NortonDesignLab/imagotag-e300-dashboard/frame/preview.png

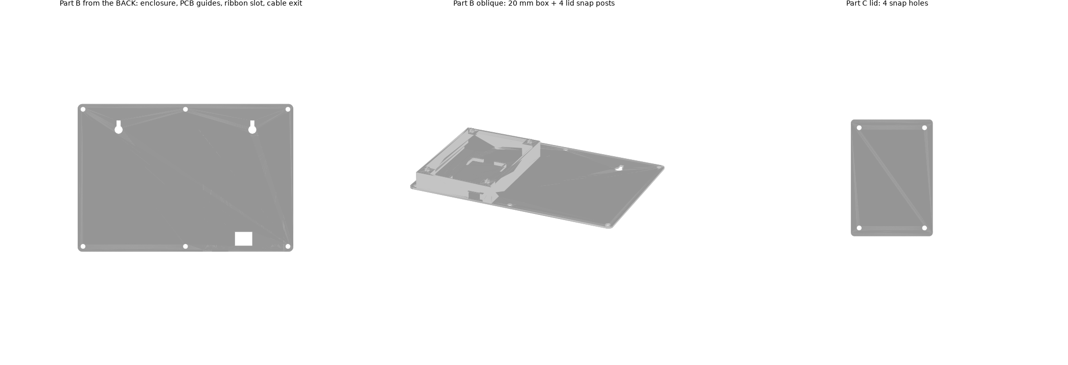
frame/preview.png
