NortonDesignLab/imagotag-e300-dashboard/NDLMessage/ndl_base_preview.png

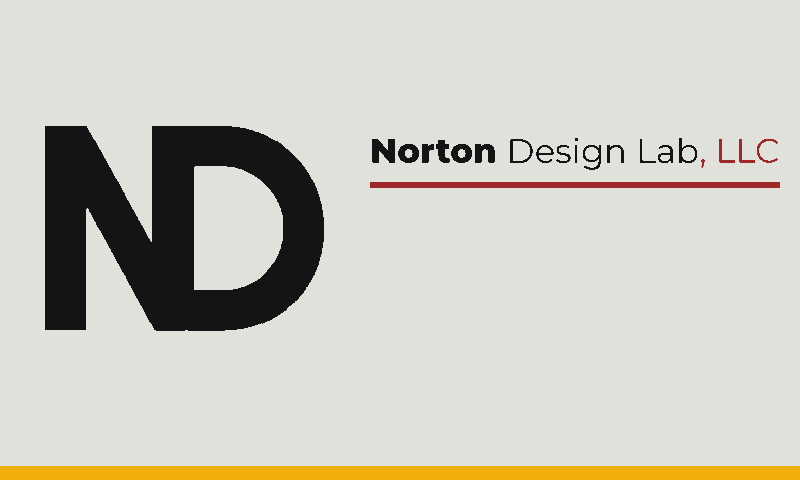
NDLMessage/ndl_base_preview.png
