NortonDesignLab/imagotag-e300-dashboard/NDLMessage/ndl_message_preview.png

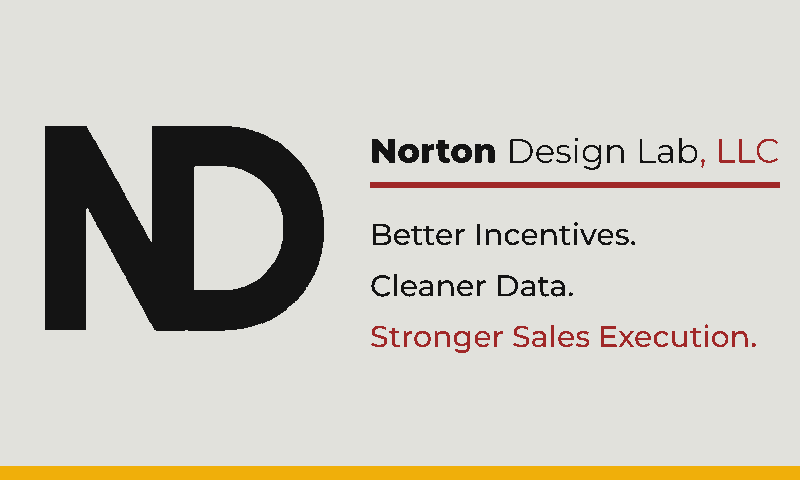
NDLMessage/ndl_message_preview.png
