NortonDesignLab/imagotag-e300-dashboard/frame/frame_both.3mf

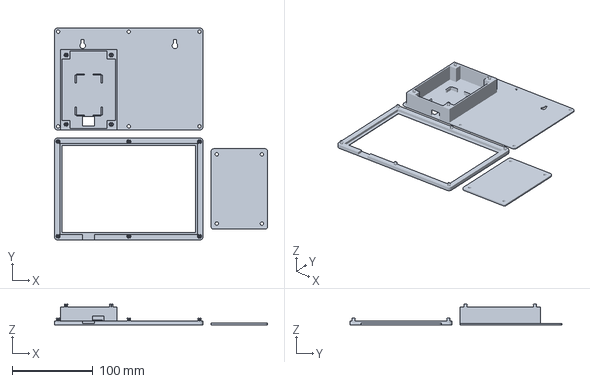
[picture p9: CAD file, 2026-10-08]
frame/frame_both.3mf
264.6 x 263.2 x 25.8 mm
