NortonDesignLab/imagotag-e300-dashboard/frame/openbox/open_box_70x100x20_wall2.stl

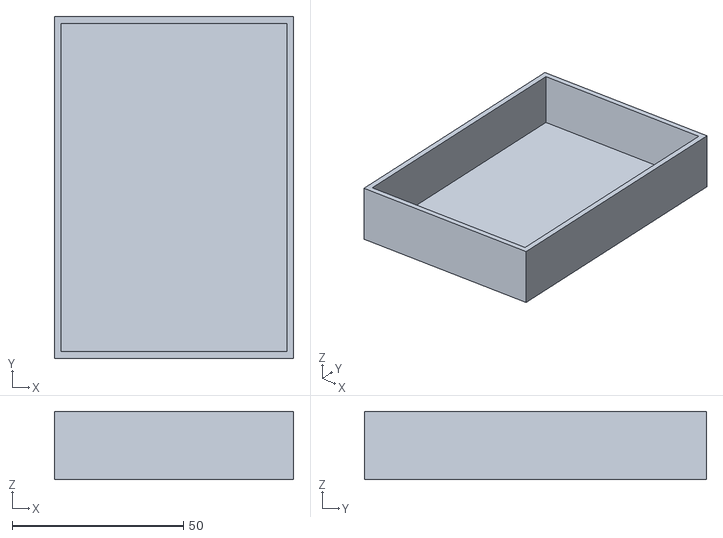
[picture p10: CAD file, 2026-10-07]
frame/openbox/open_box_70x100x20_wall2.stl
70.0 x 100.0 x 20.0
