NortonDesignLab/imagotag-e300-dashboard/frame/frame_lid.stl

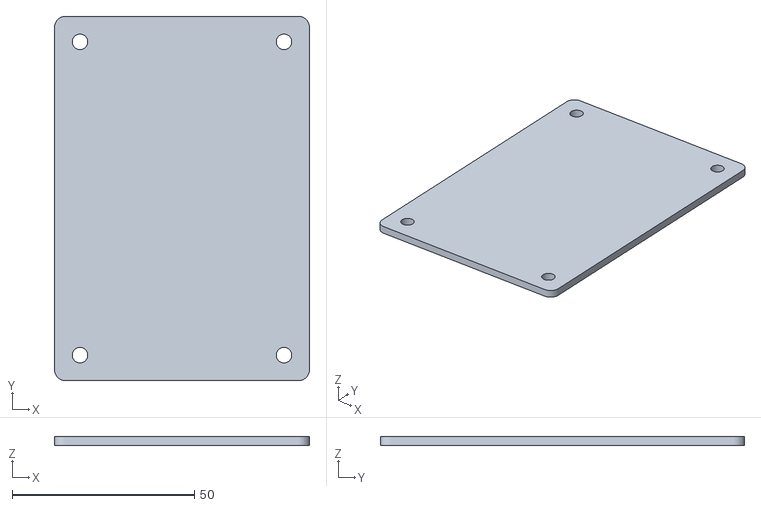
[picture p11: CAD file, 2026-10-06]
frame/frame_lid.stl
70.0 x 100.0 x 2.40
