NortonDesignLab/imagotag-e300-dashboard/frame/frame_front.stl

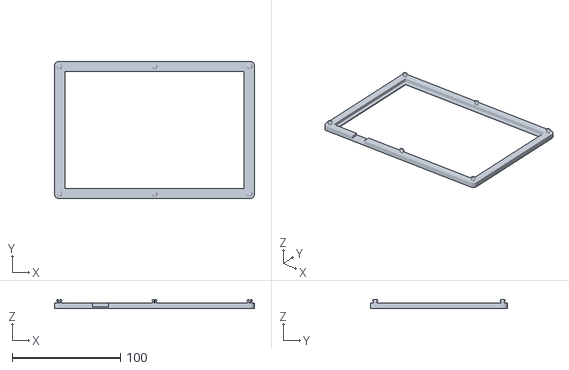
[picture p12: CAD file, 2026-10-06]
frame/frame_front.stl
184.6 x 126.6 x 8.50
