NortonDesignLab/imagotag-e300-dashboard/frame/frame_back.stl

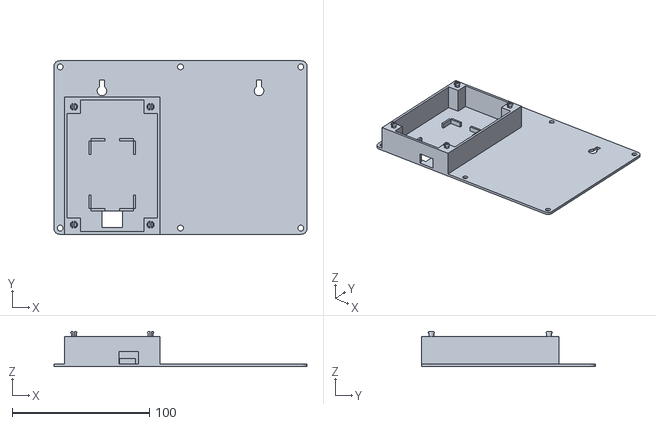
[picture p13: CAD file, 2026-10-06]
frame/frame_back.stl
184.6 x 126.6 x 25.8
