NortonDesignLab/imagotag-e300-dashboard/(list of files, cad)

Other CAD files:
frame/openbox/open_box_70x100x20_wall1.stl
frame/frame_both.stl
