NortonDesignLab/imagotag-e300-dashboard/WeatherPanel4C/WeatherPanel4C.ino

// Weather station display, 4-COLOR edition, driving the Imagotag/Vusion E300 7.4" panel =
// Pervasive Displays E2741QS0B3, Spectra 4 black/white/RED/YELLOW, 480x800 native, used in
// LANDSCAPE 800x480 (bb_epaper rotation 90). Runs on either of two driver boards (see the board
// select below): the Waveshare e-Paper ESP32 Driver Board Rev3 (ESP32-WROOM-32E) or the Seeed XIAO
// ePaper Display Board EE04 with a XIAO ESP32-S3 Plus.
//
// Port of WeatherEpaper (GxEPD2, 880x528 B/W/R) to bb_epaper. The fetch/parse half (AWN,
// ComEd, NWS, pollen.com, Open-Meteo, USGS, SWPC, Google News) is reused verbatim. The drawing half
// is re-laid out for 800x480 and gains yellow as a "caution" tier between black and red:
//   UV 3-5, pollen/asthma Medium, AQI 51-100, Kp 4, M5 quakes, lightning today but not in the last
//   hour, the ComEd hour still in progress; messages take ~yellow~.
// Yellow text is ringed in black (same trick as the NDL panel) because yellow on white is faint,
// and is never used below 12 pt.
//
// bb_epaper has no Adafruit GFX font support, and its 96 KB full-frame buffer starves TLS on this
// board, so a small Adafruit_GFX subclass pages the screen in column bands straight to the panel
// (see EpdGfx / pushScreen). bb_epaper is used for init, commands, refresh and sleep only.
// bb_epaper rejects any rect with a corner off-screen and does not clip x, so the bridge clips.
//
// Full refresh ~23 s, no fast mode. The paged renderer is kept on the S3 too (it has the RAM for a
// full frame, but paging costs nothing and keeps one code path).
// Needs bb_epaper from GIT master (EP74YR_480x800): compile with --library ../bb_epaper_git.

#include <WiFi.h>
#include <WiFiClientSecure.h>
#include <HTTPClient.h>
#include <ArduinoJson.h>
#include <bb_epaper.h>
#include <Adafruit_GFX.h>
#include <Fonts/FreeSansBold24pt7b.h>
#include <Fonts/FreeSansBold18pt7b.h>
#include <Fonts/FreeSansBold12pt7b.h>
#include <Fonts/FreeSans12pt7b.h>
#include <Fonts/FreeSans9pt7b.h>
#include <Fonts/FreeSansBold9pt7b.h>
#include "secrets.h"
#include <WebServer.h>
#include <ESPmDNS.h>

// Board select. The same sketch runs on two driver boards; the pins and the mDNS hostname are the
// only differences (the hostname differs so both boards can be on the LAN at once).
#if defined(ARDUINO_XIAO_ESP32S3_PLUS) || defined(ARDUINO_XIAO_ESP32S3)
// Seeed XIAO ePaper Display Board EE04 + XIAO ESP32-S3 Plus (16 MB flash, 8 MB PSRAM).
// FQBN esp32:esp32:XIAO_ESP32S3_Plus:PSRAM=opi,PartitionScheme=app3M_fat9M_16MB
#define BOARD_NAME "XIAO EE04 / ESP32-S3 Plus"
#define DC_PIN    10
#define RESET_PIN 38
#define BUSY_PIN  4
#define CS_PIN    44
#define SCK_PIN   7
#define MOSI_PIN  9
#define HOSTNAME  "ndl-panel-s3"
#else
// Waveshare e-Paper ESP32 Driver Board Rev3 (ESP32-WROOM-32E, 4 MB flash, no PSRAM).
// FQBN esp32:esp32:esp32:FlashSize=4M,PartitionScheme=huge_app
#define BOARD_NAME "Waveshare Rev3 / WROOM-32"
#define DC_PIN    27
#define RESET_PIN 26
#define BUSY_PIN  25
#define CS_PIN    15
#define SCK_PIN   13
#define MOSI_PIN  14
#define HOSTNAME  "ndl-panel"
#endif
#define ROTATION  90          // 270 flips the picture 180 degrees
#define SCR_W 800
#define SCR_H 480

// Colors are bb_epaper's own values, passed straight through Adafruit_GFX's 16-bit color.
#define C_BLACK  BBEP_BLACK
#define C_WHITE  BBEP_WHITE
#define C_YELLOW BBEP_YELLOW
#define C_RED    BBEP_RED

BBEPAPER bbep(EP74YR_480x800);

// Adafruit_GFX -> panel bridge, PAGED. The full 800x480 2-bpp frame is 96 KB, which this
// WROOM-32 cannot hold next to Wi-Fi + TLS (with it resident the largest free block fell to 32 KB
// and every HTTPS fetch failed). So, like GxEPD2 paging, each screen is drawn BAND_W logical
// columns at a time into a small buffer that is already in the panel's native layout, and
// streamed straight to the controller - the same bytes bbepWriteImage2bpp() sends for a 4-color
// panel at rotation 90: command 0x10, then one 120-byte native row per logical column x, packed
// 4 px/byte MSB-first from y = 479 down to 0. bb_epaper's own frame buffer is never allocated.
const int BAND_W = 80, ROW_B = SCR_H / 4;              // 10 bands of 80 columns, 9600 B buffer
static uint8_t* band = nullptr;                        // malloc'd at boot (static would crowd dram0)
static int bandX0 = 0;
class EpdGfx : public Adafruit_GFX {
 public:
  EpdGfx() : Adafruit_GFX(SCR_W, SCR_H) {}
  void drawPixel(int16_t x, int16_t y, uint16_t c) override {
    if (y < 0 || y >= SCR_H || x < bandX0 || x >= bandX0 + BAND_W) return;
    int nx = SCR_H - 1 - y;                            // native x runs bottom-up
    uint8_t* p = band + (x - bandX0) * ROW_B + (nx >> 2);
    int sh = (3 - (nx & 3)) * 2;
    *p = (*p & ~(3 << sh)) | ((c & 3) << sh);
  }
  void fillRect(int16_t x, int16_t y, int16_t w, int16_t h, uint16_t c) override {
    int x1 = max((int)x, bandX0), x2 = min((int)x + w - 1, bandX0 + BAND_W - 1);
    int y1 = max((int)y, 0),      y2 = min((int)y + h - 1, SCR_H - 1);
    for (int yy = y1; yy <= y2; yy++) for (int xx = x1; xx <= x2; xx++) drawPixel(xx, yy, c);
  }
  void drawFastHLine(int16_t x, int16_t y, int16_t w, uint16_t c) override { fillRect(x, y, w, 1, c); }
  void drawFastVLine(int16_t x, int16_t y, int16_t h, uint16_t c) override { fillRect(x, y, 1, h, c); }
  void fillScreen(uint16_t c) override { uint8_t v = c & 3; memset(band, v | v << 2 | v << 4 | v << 6, BAND_W * ROW_B); }
};
EpdGfx display;
static bool panelAsleep = false;

// ---------------- message-over-Wi-Fi ----------------
// POST /message  text=...&style=banner|full&ttl=<minutes, 0 = until cleared>
// POST /clear    ;  GET / = browser form.  Host: http://ndl-panel.local  (mDNS) or the board IP.
WebServer server(80);
String   msgText;                  // empty = no message
bool     msgFull    = false;       // full screen vs banner strip
uint32_t msgSetMs   = 0, msgTtlMs = 0;
bool     needRender = false;

// ---------------- ComEd hourly pricing ----------------
// northern Illinois. Free, no key. Two calls:
//   ?type=currenthouraverage -> JSON [{millisUTC,price}]  (45 B)
//   ?type=day&date=YYYYMMDD  -> JavaScript, NOT JSON: [[Date.UTC(y,m,d,H,0,0), price], ...]  (~550 B)
// The Date.UTC() hours are LOCAL clock hours despite the name, and they are HOUR-ENDING: H = the
// hour that ended at H:00 (verified 26 Oct 2026: entry 18 = 17.5c = the mean of the 5-minute
// prices from 5-6 PM CDT). So H goes into slot H-1 of a local 0..23 hour-starting array; H = 0 is
// yesterday's 11 PM hour and is dropped. The hour in progress is never in the feed.
const float ALERT_C = 8.0f;              // cents/kWh: at or above this is drawn red
float  comedHour[24];
float  comedCur = NAN;
int    comedN = 0;
time_t comedAt = 0;
const uint32_t COMED_MS = 5UL * 60 * 1000;
uint32_t lastComed = 0;

// ---------------- NWS forecast ----------------
// Free, no key, no special User-Agent needed. The gridpoint is fixed for a location - it came
// NWS_GRID (secrets.h) comes from GET /points/<lat>,<lon> -> gridId/gridX/gridY. Re-derive it
// if SITE_LATITUDE/SITE_LONGITUDE change. Body is ~13.6 KB, well inside BODY_CAP.
const char* NWS_URL = "https://api.weather.gov/gridpoints/" NWS_GRID "/forecast";
struct Period { char name[20]; char shortF[48]; char wind[24]; int temp; int pop; bool day; };
Period  fc[5];
int     fcN = 0;
char    fcDetail[320] = "";
time_t  fcAt = 0;
const uint32_t FC_MS = 30UL * 60 * 1000;    // NWS refreshes about hourly
uint32_t lastFc = 0;

// ---------------- pollen + air quality ----------------
// Pollen: pollen.com by ZIP, free/keyless but REQUIRES a Referer header or it returns nothing.
//   Index is 0-12 and it names the active triggers. Its /mold/ endpoint returns null for some ZIPs -
//   there is effectively no mold data for this area (NAB counts have no public API).
// AQI: Open-Meteo air-quality, free/keyless. NOTE its pollen fields are Europe-only and come back
//   null for US coordinates, which is why pollen comes from pollen.com instead.
const char* POLLEN_ZIP = SITE_ZIP;
float  pollenIdx = NAN;
char   pollenTrig[72] = "";
int    aqiVal = -1;
float  pm25 = NAN;
float  asthmaIdx = NAN;
float  pm10 = NAN, ozone = NAN;
float  pollen5[5];
int    p5mon[5], p5day[5], pollen5N = 0;
time_t airAt = 0;
const uint32_t AIR_MS = 30UL * 60 * 1000;
uint32_t lastAir = 0;

// ---------------- NWS severe weather alerts ----------------
// api.weather.gov/alerts/active?point=lat,lon - free, keyless, tiny payload (196 B when clear).
// Only Tornado / Severe Thunderstorm WARNINGS raise the box (watches and advisories do not).
bool   alertActive = false;
char   alertEvent[48] = "";
char   alertArea[72]  = "";
time_t alertEnds = 0;
int    alertRank = 0;                        // 2 = tornado, 1 = thunderstorm
const uint32_t ALERT_MS = 2UL * 60 * 1000;   // time-critical: poll every 2 min
uint32_t lastAlert = 0;
bool     alertTest = false;      // /testalert holds the box up without a real storm

// ---------------- WSJ headlines ----------------
// WSJ's own RSS (feeds.a.dj.com) is DEAD - frozen since 27 Jan 2025 (origin last-modified proves
// it, and a cache-buster changes nothing). Google News filtered to site:wsj.com is live. The feed
// is ~120 KB but the top 8 items land inside 11 KB, so we read ~16 KB and hang up.
const char* NEWS_URL =
  "https://news.google.com/rss/search?q=site:wsj.com+when:2d&hl=en-US&gl=US&ceid=US:en";
struct Story { char title[124]; time_t t; };
const int NEWS_MAX = 8;
Story  NEWS[NEWS_MAX];
int    newsN = 0;
time_t newsAt = 0;
const uint32_t NEWS_MS = 30UL * 60 * 1000;
uint32_t lastNews = 0;

// ---------------- river gauge (USGS) ----------------
// RIVER_USGS_SITE from secrets.h (any USGS gauge with gage height). Keyless, 15-minute cadence.
// 00065 = gage height (ft), 00060 = streamflow (ft3/s).
// Flood stages (ft) from the NWS gauge page water.noaa.gov/gauges/<RIVER_NWSLI>, via secrets.h.
const char* USGS_SITE = RIVER_USGS_SITE;
const float FLOOD_ACTION   = RIVER_FLOOD_ACTION;
const float FLOOD_MINOR    = RIVER_FLOOD_MINOR;     // "flood stage"
const float FLOOD_MODERATE = RIVER_FLOOD_MODERATE;
const float FLOOD_MAJOR    = RIVER_FLOOD_MAJOR;
float  rivStage = NAN, rivFlow = NAN, rivFirst = NAN;
float  rivHist[48]; int rivHistN = 0;
time_t rivAt = 0;
const uint32_t RIVER_MS = 15UL * 60 * 1000;
// USGS/NOAA 503 transiently. A failure at boot used to leave a screen blank until the next full
// interval - 15 min for the river. Re-attempt in 2 min instead. Due-times are compared as signed
// differences so millis() rollover is handled.
const uint32_t RETRY_MS = 2UL * 60 * 1000;
uint32_t riverDue = 0, quakeDue = 0, spaceDue = 0;
uint32_t lastRiver = 0;

// ---------------- earthquakes (USGS) ----------------
struct Quake { char place[58]; float mag; float dist; time_t t; };   // dist = miles from SITE
const int QK_MAX = 7;
Quake  QK[QK_MAX]; int qkN = 0, qkTotal = 0; float qkBig = 0; time_t qkAt = 0;
const uint32_t QUAKE_MS = 15UL * 60 * 1000;
uint32_t lastQuake = 0;

// ---------------- space weather (NOAA SWPC) ----------------
float  kpNow = NAN; float kpHist[24]; time_t kpTime[24]; int kpHistN = 0; time_t kpAt = 0;
const uint32_t SPACE_MS = 30UL * 60 * 1000;
uint32_t lastSpace = 0;

// ---------------- screen rotation ----------------
enum Screen { SCR_WEATHER = 0, SCR_FORECAST = 1, SCR_AIR = 2, SCR_RIVER = 3, SCR_SPACE = 4,
              SCR_QUAKE = 5, SCR_COMED = 6, SCR_NEWS = 7 };
const int NUM_SCREENS = 8;
// Rotation is these five in order (Bradley, 27 Oct 2026). Space, quake and news are still
// compiled and reachable with /screen?s=..., just not in the cycle.
const Screen CYCLE[] = { SCR_WEATHER, SCR_FORECAST, SCR_COMED, SCR_AIR, SCR_RIVER };
const int NCYCLE = sizeof(CYCLE) / sizeof(CYCLE[0]);
int rotSlot = 0;
Screen   curScreen = SCR_WEATHER;
uint32_t rotateMs  = 3UL * 60 * 1000;           // 0 = stay on the current screen
uint32_t lastRotate = 0;

const float INHG2MB = 33.8639f;
const uint32_t CURRENT_MS = 10UL * 60 * 1000;   // poll current every 10 min (Bradley, 21 Sep 2026)
const uint32_t HISTORY_MS = 10UL * 60 * 1000;   // poll history every 10 min
static const int HIST_MAX   = 60;
static const int HIST_LIMIT = 48;               // 5-min samples -> 4 h (covers the 3 h trend)
const float TREND_MB = 0.7f;
const double SITE_LAT = SITE_LATITUDE, SITE_LON = SITE_LONGITUDE;   // from secrets.h

// ---------------- data ----------------
struct Obs {
  float tempf = NAN, humidity = NAN, feelsLike = NAN, dewPoint = NAN;
  float baromRel = NAN, baromAbs = NAN, windMph = NAN, windGust = NAN, dailyRain = NAN;
  float ltgDay = NAN, ltgHour = NAN, ltgDist = NAN; time_t ltgTime = 0;
  float windDir = NAN, windDirAvg = NAN, windAvg = NAN, maxGust = NAN;
  float uv = NAN, solar = NAN, tempIn = NAN, humIn = NAN;
  float rainHour = NAN, rainWeek = NAN, rainMonth = NAN, rainYear = NAN;
  time_t lastRainT = 0;
  time_t t = 0;
  bool ok = false;
};
Obs cur;
float  histP[HIST_MAX];
time_t histT[HIST_MAX];
int    histN = 0;
float  trendDelta = NAN;
int    trendSpanMin = 0;
String lastErr;
uint16_t fetchOk = 0, fetchTotal = 0;
time_t lastGood = 0;
// Today's high/low. Not in the AWN feed, so backfilled from midnight at boot by paging the
// history endpoint with endDate (48 recs / ~36 KB / 4 h per call), then tracked forward.
float  dayHi = NAN, dayLo = NAN;
time_t dayHiT = 0, dayLoT = 0;
int    dayKey = -1;                 // tm_yday the hi/lo belong to

// ---------------- helpers ----------------
static String fmtTime(time_t t, const char* fmt = "%l:%M %p") {
  if (t < 1000000000) return "--:--";     // 0 / pre-NTP values render as "6:00 PM" (epoch in Chicago)
  struct tm tm; localtime_r(&t, &tm);
  char buf[32]; strftime(buf, sizeof buf, fmt, &tm);
  String s(buf); s.trim(); return s;
}
static String f0(float v, const char* suffix = "") { char b[16]; if (isnan(v)) return "--"; snprintf(b, sizeof b, "%.0f%s", v, suffix); return String(b); }
static String f1(float v, const char* suffix = "") { char b[16]; if (isnan(v)) return "--"; snprintf(b, sizeof b, "%.1f%s", v, suffix); return String(b); }

// ---------------- Ambient Weather fetch (reused from ideaspark / C6) ----------------
static const char* KEEP[] = {"dateutc","tempf","humidity","feelsLike","dewPoint","baromrelin",
                             "baromabsin","windspeedmph","windgustmph","dailyrainin",
                             "lightning_day","lightning_hour","lightning_distance","lightning_time",
                             "winddir","winddir_avg10m","windspdmph_avg10m","maxdailygust",
                             "uv","solarradiation","tempinf","humidityin",
                             "hourlyrainin","weeklyrainin","monthlyrainin","yearlyrainin","lastRain"};
static const size_t BODY_CAP = 48000;
static char bodyBuf[BODY_CAP];
static bool httpGetRaw(const String& url, size_t& outLen, size_t maxBytes = BODY_CAP - 1,
                       const char* referer = nullptr) {
  uint32_t t0 = millis();
  WiFiClientSecure client; client.setInsecure();
  HTTPClient https;
  https.useHTTP10(true);
  https.setTimeout(15000);
  https.setUserAgent("Mozilla/5.0 (X11; Linux x86_64)");   // some feeds reject the default ESP32 UA
  if (!https.begin(client, url)) { lastErr = "begin failed"; return false; }
  if (referer) https.addHeader("Referer", referer);   // pollen.com returns nothing without it
  int code = https.GET();
  if (code != HTTP_CODE_OK) {
    lastErr = "HTTP " + String(code);
    if (code == 401) lastErr += " keys";
    if (code == 429) lastErr += " rate";
    Serial.printf("  GET %s FAILED: %s\n", url.substring(0, 45).c_str(), lastErr.c_str());
    https.end(); return false;
  }
  NetworkClient* st = https.getStreamPtr();
  size_t len = 0; uint32_t last = millis();
  if (maxBytes > BODY_CAP - 1) maxBytes = BODY_CAP - 1;
  while (millis() - last < 5000 && len < maxBytes) {
    int n = st->available();
    if (n > 0) {
      if ((size_t)n > maxBytes - len) n = maxBytes - len;
      n = st->read((uint8_t*)bodyBuf + len, n);
      if (n > 0) { len += n; last = millis(); }
    } else { if (!st->connected()) break; delay(1); }
  }
  https.end();
  bodyBuf[len] = 0; outLen = len;
  Serial.printf("  GET %s -> %u bytes in %lu ms (heap %u)\n", url.substring(0, 45).c_str(),
                (unsigned)len, (unsigned long)(millis() - t0), (unsigned)ESP.getFreeHeap());
  return len > 0;
}
static bool awGet(const String& url, JsonDocument& doc, const JsonDocument& filter,
                  const char* referer = nullptr) {
  size_t len;
  if (!httpGetRaw(url, len, BODY_CAP - 1, referer)) return false;
  DeserializationError err = deserializeJson(doc, bodyBuf, len, DeserializationOption::Filter(filter));
  if (err) { lastErr = String("JSON ") + err.c_str(); Serial.printf("  parse: %s\n", err.c_str()); return false; }
  return true;
}
// "2026-09-27T12:57:00.000Z" -> UTC epoch (days-from-civil, Howard Hinnant)
static time_t parseISO(const char* s) {
  int y, mo, d, h, mi, se;
  if (!s || sscanf(s, "%d-%d-%dT%d:%d:%d", &y, &mo, &d, &h, &mi, &se) != 6) return 0;
  y -= mo <= 2;
  long era = (y >= 0 ? y : y - 399) / 400;
  unsigned yoe = (unsigned)(y - era * 400);
  unsigned doy = (153 * (mo + (mo > 2 ? -3 : 9)) + 2) / 5 + d - 1;
  unsigned doe = yoe * 365 + yoe / 4 - yoe / 100 + doy;
  long days = era * 146097L + (long)doe - 719468L;
  time_t t = (time_t)(days * 86400L + h * 3600L + mi * 60L + se);
  const char* z = s + 19;                       // past "....-..-..T..:..:.."
  while (*z == '.' || (*z >= '0' && *z <= '9')) z++;   // skip fractional seconds
  if (*z == '+' || *z == '-') {                 // NWS stamps carry -06:00 etc, not Z
    int oh = 0, om = 0;
    if (sscanf(z + 1, "%d:%d", &oh, &om) == 2) {
      long off = oh * 3600L + om * 60L;
      t += (*z == '+') ? -off : off;
    }
  }
  return t;
}
static const char* CARD16[] = {"N","NNE","NE","ENE","E","ESE","SE","SSE","S","SSW","SW","WSW","W","WNW","NW","NNW"};
static String cardinal(float deg) {
  if (isnan(deg)) return "";
  int i = ((int)((deg + 11.25f) / 22.5f)) % 16; if (i < 0) i += 16;
  return String(CARD16[i]);
}
// ESP32 newlib's struct tm has no tm_gmtoff, so derive the UTC offset by comparing
// the local and UTC breakdowns of the same instant (handles the day/month wrap).
static long tzOffsetSec(time_t t) {
  struct tm lt, gt;
  localtime_r(&t, &lt); gmtime_r(&t, &gt);
  long d = (lt.tm_hour * 3600L + lt.tm_min * 60L + lt.tm_sec)
         - (gt.tm_hour * 3600L + gt.tm_min * 60L + gt.tm_sec);
  int dd = lt.tm_mday - gt.tm_mday;
  if (dd == 1 || dd < -1) d += 86400;        // local is the next day
  else if (dd == -1 || dd > 1) d -= 86400;   // local is the previous day
  return d;
}
// Sunrise equation (NOAA / Wikipedia), good to ~1-2 min. Returns local minutes from midnight.
static void sunTimes(int y, int mo, int d, double lat, double lon, long tzoff, double& rise, double& set) {
  long a = (14 - mo) / 12, yy = y + 4800 - a, mm = mo + 12 * a - 3;
  long jdn = d + (153 * mm + 2) / 5 + 365 * yy + yy / 4 - yy / 100 + yy / 400 - 32045;
  double n = (double)jdn - 2451545.0 + 0.0008;
  double Js = n - lon / 360.0;
  double M = fmod(357.5291 + 0.98560028 * Js, 360.0), Mr = M * DEG_TO_RAD;
  double C = 1.9148 * sin(Mr) + 0.0200 * sin(2 * Mr) + 0.0003 * sin(3 * Mr);
  double lam = fmod(M + C + 180.0 + 102.9372, 360.0), lr = lam * DEG_TO_RAD;
  double Jtr = 2451545.0 + Js + 0.0053 * sin(Mr) - 0.0069 * sin(2 * lr);
  double sinDec = sin(lr) * sin(23.4397 * DEG_TO_RAD);
  double cosDec = cos(asin(sinDec)), latr = lat * DEG_TO_RAD;
  double cosW = (sin(-0.833 * DEG_TO_RAD) - sin(latr) * sinDec) / (cos(latr) * cosDec);
  if (cosW > 1 || cosW < -1) { rise = set = NAN; return; }   // polar day / night
  double w = acos(cosW) * RAD_TO_DEG;
  auto toLocal = [&](double J) {
    double mins = (J - (double)jdn + 0.5) * 1440.0 + tzoff / 60.0;
    while (mins < 0) mins += 1440; while (mins >= 1440) mins -= 1440;
    return mins;
  };
  rise = toLocal(Jtr - w / 360.0); set = toLocal(Jtr + w / 360.0);
}
static String fmtMin(double m) {
  if (isnan(m)) return "--";
  int t = (int)(m + 0.5), h = (t / 60) % 24, mi = t % 60, hh = h % 12; if (!hh) hh = 12;
  char b[16]; snprintf(b, sizeof b, "%d:%02d %s", hh, mi, h < 12 ? "AM" : "PM"); return String(b);
}
static String agoStr(time_t then, time_t now) {
  if (then <= 0) return "never";
  long s = now - then; if (s < 0) s = 0;
  if (s < 3600) return String(s / 60) + "m ago";
  if (s < 86400) return String(s / 3600) + "h ago";
  return String(s / 86400) + "d ago";
}
static void parseObs(JsonObject o) {
  cur.tempf     = o["tempf"]        | NAN;
  cur.humidity  = o["humidity"]     | NAN;
  cur.feelsLike = o["feelsLike"]    | NAN;
  cur.dewPoint  = o["dewPoint"]     | NAN;
  cur.baromRel  = (o["baromrelin"] | NAN) * INHG2MB;
  cur.baromAbs  = (o["baromabsin"] | NAN) * INHG2MB;
  cur.windMph   = o["windspeedmph"] | NAN;
  cur.windGust  = o["windgustmph"]  | NAN;
  cur.dailyRain = o["dailyrainin"]  | NAN;
  cur.ltgDay    = o["lightning_day"]      | NAN;
  cur.ltgHour   = o["lightning_hour"]     | NAN;
  cur.ltgDist   = o["lightning_distance"] | NAN;
  cur.ltgTime   = (time_t)((o["lightning_time"] | 0.0) / 1000.0);
  cur.windDir   = o["winddir"]            | NAN;
  cur.windDirAvg= o["winddir_avg10m"]     | NAN;
  cur.windAvg   = o["windspdmph_avg10m"]  | NAN;
  cur.maxGust   = o["maxdailygust"]       | NAN;
  cur.uv        = o["uv"]                 | NAN;
  cur.solar     = o["solarradiation"]     | NAN;
  cur.tempIn    = o["tempinf"]            | NAN;
  cur.humIn     = o["humidityin"]         | NAN;
  cur.rainHour  = o["hourlyrainin"]       | NAN;
  cur.rainWeek  = o["weeklyrainin"]       | NAN;
  cur.rainMonth = o["monthlyrainin"]      | NAN;
  cur.rainYear  = o["yearlyrainin"]       | NAN;
  cur.lastRainT = parseISO(o["lastRain"]  | "");
  cur.t         = (time_t)((o["dateutc"] | 0.0) / 1000.0);
  cur.ok        = true;
}
static void computeTrend() {
  if (histN < 2 || !cur.ok || isnan(cur.baromRel)) { trendDelta = NAN; return; }
  time_t target = cur.t - 3 * 3600; int best = -1;
  for (int i = 0; i < histN; i++)
    if (best < 0 || labs((long)(histT[i] - target)) < labs((long)(histT[best] - target))) best = i;
  if (best < 0) return;
  trendDelta = cur.baromRel - histP[best];
  trendSpanMin = (int)((cur.t - histT[best]) / 60);
}
bool fetchCurrent() {
  String url = String("https://rt.ambientweather.net/v1/devices?apiKey=") + AW_API_KEY +
               "&applicationKey=" + AW_APP_KEY;
  JsonDocument filter;
  filter[0]["macAddress"] = true;
  for (auto k : KEEP) filter[0]["lastData"][k] = true;
  JsonDocument doc;
  if (!awGet(url, doc, filter)) return false;
  JsonArray arr = doc.as<JsonArray>();
  if (arr.size() == 0) { lastErr = "no devices"; return false; }
  JsonObject dev = arr[0];
  for (JsonObject d : arr) if (String(d["macAddress"] | "").equalsIgnoreCase(AW_MAC)) { dev = d; break; }
  JsonObject o = dev["lastData"];
  if (o.isNull()) { lastErr = "no lastData"; return false; }
  parseObs(o);
  if (histN > 0 && cur.t > histT[histN - 1] && !isnan(cur.baromRel)) {
    if (histN == HIST_MAX) { memmove(histP, histP + 1, sizeof(float) * (HIST_MAX - 1)); memmove(histT, histT + 1, sizeof(time_t) * (HIST_MAX - 1)); histN--; }
    histP[histN] = cur.baromRel; histT[histN] = cur.t; histN++;
  }
  if (!isnan(cur.tempf) && cur.t > 0) {            // extend today's hi/lo with the new reading
    struct tm lt; localtime_r(&cur.t, &lt);
    if (lt.tm_yday == dayKey) {
      if (isnan(dayHi) || cur.tempf > dayHi) { dayHi = cur.tempf; dayHiT = cur.t; }
      if (isnan(dayLo) || cur.tempf < dayLo) { dayLo = cur.tempf; dayLoT = cur.t; }
    }
  }
  computeTrend(); time(&lastGood); lastErr = ""; return true;
}
bool fetchHistory() {
  String url = String("https://rt.ambientweather.net/v1/devices/") + AW_MAC +
               "?apiKey=" + AW_API_KEY + "&applicationKey=" + AW_APP_KEY +
               "&limit=" + String(HIST_LIMIT);
  JsonDocument filter;                       // history only needs these two - keeps the parsed doc small
  filter[0]["dateutc"] = true; filter[0]["baromrelin"] = true;
  JsonDocument doc;
  if (!awGet(url, doc, filter)) return false;
  JsonArray arr = doc.as<JsonArray>();
  int n = arr.size();
  if (n == 0) { lastErr = "no data"; return false; }
  if (n > HIST_MAX) n = HIST_MAX;
  histN = 0;
  for (int i = n - 1; i >= 0; i--) {
    JsonObject o = arr[i];
    histP[histN] = (o["baromrelin"] | NAN) * INHG2MB;
    histT[histN] = (time_t)((o["dateutc"] | 0.0) / 1000.0);
    histN++;
  }
  if (!cur.ok) { parseObs(arr[0]); time(&lastGood); }
  computeTrend(); lastErr = ""; return true;
}
// ---------------- river / quakes / space weather fetches ----------------
bool fetchRiver() {
  char url[256];
  snprintf(url, sizeof url,
           "https://waterservices.usgs.gov/nwis/iv/?format=json&sites=%s"
           "&parameterCd=00065,00060&period=P1D", USGS_SITE);
  JsonDocument filter;
  JsonObject ts = filter["value"]["timeSeries"][0].to<JsonObject>();
  ts["variable"]["variableCode"][0]["value"] = true;
  ts["values"][0]["value"][0]["value"] = true;
  JsonDocument doc;
  if (!awGet(url, doc, filter)) return false;
  rivHistN = 0;
  for (JsonObject t : doc["value"]["timeSeries"].as<JsonArray>()) {
    String code = t["variable"]["variableCode"][0]["value"] | "";
    JsonArray v = t["values"][0]["value"];
    if (v.size() == 0) continue;
    float last = atof(v[v.size() - 1]["value"] | "nan");
    if (code == "00060") { rivFlow = last; continue; }
    if (code != "00065") continue;
    rivStage = last;
    rivFirst = atof(v[0]["value"] | "nan");
    int n = v.size(), stride = n > 48 ? (n + 47) / 48 : 1;   // downsample to <=48 points
    for (int i = 0; i < n && rivHistN < 48; i += stride) {
      float f = atof(v[i]["value"] | "nan");
      if (!isnan(f)) rivHist[rivHistN++] = f;
    }
  }
  if (isnan(rivStage)) { lastErr = "no stage"; return false; }
  time(&rivAt);
  Serial.printf("river: %.2f ft, %.0f ft3/s, %d pts\n", rivStage, rivFlow, rivHistN);
  return true;
}
static float haversineMi(double lat1, double lon1, double lat2, double lon2) {
  const double R = 3958.8;                                   // mean earth radius, miles
  double dLat = (lat2 - lat1) * DEG_TO_RAD, dLon = (lon2 - lon1) * DEG_TO_RAD;
  double a = sin(dLat / 2) * sin(dLat / 2) +
             cos(lat1 * DEG_TO_RAD) * cos(lat2 * DEG_TO_RAD) * sin(dLon / 2) * sin(dLon / 2);
  return (float)(2.0 * R * asin(sqrt(a)));
}
bool fetchQuakes() {
  JsonDocument filter;
  JsonObject ff = filter["features"][0].to<JsonObject>();
  ff["properties"]["mag"] = true; ff["properties"]["place"] = true; ff["properties"]["time"] = true;
  ff["geometry"]["coordinates"] = true;
  // US only (Bradley: "US is more interesting"). The canned summary feeds are global, so use the
  // FDSN query API with a US bounding box - covers the lower 48 plus Alaska and Hawaii. Sorted
  // nearest-first below, so lower-48 events lead and Alaska falls to the bottom.
  // M2.5+/24 h gives ~15 events (~11 KB); the lower 48 alone gives only ~6, too sparse.
  time_t nw; time(&nw);
  struct tm g; gmtime_r(&nw, &g);                       // FDSN wants UTC
  time_t st = nw - 86400; struct tm gs; gmtime_r(&st, &gs);
  char ts[24]; strftime(ts, sizeof ts, "%Y-%m-%dT%H:%M:%S", &gs);
  char url[288];
  snprintf(url, sizeof url,
           "https://earthquake.usgs.gov/fdsnws/event/1/query?format=geojson&orderby=time"
           "&minlatitude=17&maxlatitude=72&minlongitude=-180&maxlongitude=-64"
           "&minmagnitude=2.5&starttime=%s", ts);
  JsonDocument doc;
  if (!awGet(url, doc, filter)) return false;
  JsonArray fs = doc["features"];
  qkTotal = fs.size(); qkN = 0; qkBig = 0;
  for (JsonObject f : fs) {
    float m = f["properties"]["mag"] | NAN;
    if (isnan(m)) continue;
    if (m > qkBig) qkBig = m;                                // largest across the WHOLE feed
    JsonArray c = f["geometry"]["coordinates"];
    if (c.size() < 2) continue;
    float d = haversineMi(SITE_LAT, SITE_LON, c[1] | 0.0, c[0] | 0.0);
    // keep the QK_MAX nearest, insertion-sorted by distance
    if (qkN == QK_MAX && d >= QK[qkN - 1].dist) continue;
    int pos = qkN < QK_MAX ? qkN : QK_MAX - 1;
    while (pos > 0 && QK[pos - 1].dist > d) { QK[pos] = QK[pos - 1]; pos--; }
    char raw[96]; strlcpy(raw, f["properties"]["place"] | "", sizeof raw);
    asciiClean(QK[pos].place, sizeof QK[pos].place, raw);
    QK[pos].mag = m; QK[pos].dist = d;
    QK[pos].t = (time_t)((double)(f["properties"]["time"] | 0.0) / 1000.0);
    if (qkN < QK_MAX) qkN++;
  }
  time(&qkAt);
  Serial.printf("quakes(US): %d of %d (M2.5+ 24h), nearest %.0f mi, largest M%.1f\n",
                qkN, qkTotal, qkN ? QK[0].dist : -1.0f, qkBig);
  return qkN > 0;
}
bool fetchSpace() {
  JsonDocument filter;
  filter[0]["Kp"] = true; filter[0]["time_tag"] = true;
  JsonDocument doc;
  if (!awGet("https://services.swpc.noaa.gov/products/noaa-planetary-k-index.json", doc, filter))
    return false;
  JsonArray a = doc.as<JsonArray>();
  if (!a.size()) { lastErr = "no kp"; return false; }
  int n = a.size(), start = n > 24 ? n - 24 : 0;     // last 24 samples = 3 days at 3 h
  kpHistN = 0;
  for (int i = start; i < n; i++) {
    float k = a[i]["Kp"] | NAN;
    if (!isnan(k) && kpHistN < 24) {
      kpTime[kpHistN] = parseISO(a[i]["time_tag"] | "");   // SWPC time_tag is bare UTC
      kpHist[kpHistN++] = k;
    }
  }
  kpNow = kpHistN ? kpHist[kpHistN - 1] : NAN;
  time(&kpAt);
  Serial.printf("space: Kp %.2f (%d samples)\n", kpNow, kpHistN);
  return true;
}

// ---------------- pollen + AQI fetch ----------------
static const char* pollenBand(float v) {
  if (isnan(v)) return "";
  if (v < 2.5f) return "Low";  if (v < 4.9f) return "Low-Med";
  if (v < 7.3f) return "Medium"; if (v < 9.7f) return "Med-High";
  return "High";
}
static const char* aqiBand(int a) {
  if (a <= 50)  return "Good";       if (a <= 100) return "Moderate";
  if (a <= 150) return "Unhealthy-Sens"; if (a <= 200) return "Unhealthy";
  if (a <= 300) return "Very Unhealthy";
  return "Hazardous";
}
bool fetchAir() {
  bool any = false;
  { String url = String("https://www.pollen.com/api/forecast/current/pollen/") + POLLEN_ZIP;
    String ref = String("https://www.pollen.com/forecast/current/pollen/") + POLLEN_ZIP;
    JsonDocument filter;
    JsonObject pf = filter["Location"]["periods"][0].to<JsonObject>();
    pf["Index"] = true; pf["Type"] = true;
    pf["Triggers"][0]["Name"] = true;
    JsonDocument doc;
    if (awGet(url, doc, filter, ref.c_str())) {
      for (JsonObject per : doc["Location"]["periods"].as<JsonArray>()) {
        if (String(per["Type"] | "") != "Today") continue;
        pollenIdx = per["Index"] | NAN;
        pollenTrig[0] = 0;
        int k = 0;
        for (JsonObject tg : per["Triggers"].as<JsonArray>()) {
          const char* nm = tg["Name"] | "";
          if (!nm[0] || k >= 3) continue;                 // three is all that fits on the line
          if (k) strlcat(pollenTrig, ", ", sizeof pollenTrig);
          strlcat(pollenTrig, nm, sizeof pollenTrig);
          k++;
        }
        any = true;
      }
    }
  }
  delay(300);
  { String url = String("https://www.pollen.com/api/forecast/current/asthma/") + POLLEN_ZIP;
    String ref = String("https://www.pollen.com/forecast/current/asthma/") + POLLEN_ZIP;
    JsonDocument filter;
    JsonObject pf = filter["Location"]["periods"][0].to<JsonObject>();
    pf["Index"] = true; pf["Type"] = true;
    JsonDocument doc;
    if (awGet(url, doc, filter, ref.c_str()))
      for (JsonObject per : doc["Location"]["periods"].as<JsonArray>())
        if (String(per["Type"] | "") == "Today") { asthmaIdx = per["Index"] | NAN; any = true; }
  }
  delay(300);
  { String url = String("https://www.pollen.com/api/forecast/extended/pollen/") + POLLEN_ZIP;
    String ref = String("https://www.pollen.com/forecast/extended/pollen/") + POLLEN_ZIP;
    JsonDocument filter;
    JsonObject pf = filter["Location"]["periods"][0].to<JsonObject>();
    pf["Index"] = true; pf["Period"] = true;
    JsonDocument doc;
    if (awGet(url, doc, filter, ref.c_str())) {
      pollen5N = 0;
      for (JsonObject per : doc["Location"]["periods"].as<JsonArray>()) {
        if (pollen5N >= 5) break;
        int yy, mm, dd;
        const char* pd = per["Period"] | "";          // "2026-09-29T15:37:50.027"
        if (sscanf(pd, "%d-%d-%d", &yy, &mm, &dd) != 3) continue;
        pollen5[pollen5N] = per["Index"] | NAN;
        p5mon[pollen5N] = mm; p5day[pollen5N] = dd;
        pollen5N++;
      }
      any = true;
    }
  }
  { char url[224];
    snprintf(url, sizeof url,
             "https://air-quality-api.open-meteo.com/v1/air-quality?latitude=%.4f&longitude=%.4f"
             "&current=us_aqi,pm2_5,pm10,ozone&timezone=America%%2FChicago", SITE_LAT, SITE_LON);
    JsonDocument filter;
    JsonObject cf = filter["current"].to<JsonObject>();
    cf["us_aqi"] = true; cf["pm2_5"] = true; cf["pm10"] = true; cf["ozone"] = true;
    JsonDocument doc;
    if (awGet(url, doc, filter)) {
      aqiVal = doc["current"]["us_aqi"] | -1;
      pm25   = doc["current"]["pm2_5"]  | NAN;
      pm10   = doc["current"]["pm10"]   | NAN;
      ozone  = doc["current"]["ozone"]  | NAN;
      any = true;
    }
  }
  if (any) time(&airAt);
  Serial.printf("air: pollen %.1f (%s) [%s]  asthma %.1f  AQI %d  PM2.5 %.1f  %d-day fc\n",
                pollenIdx, pollenBand(pollenIdx), pollenTrig, asthmaIdx, aqiVal, pm25, pollen5N);
  return any;
}

// ---------------- WSJ headlines fetch ----------------
// The GFX fonts are ASCII-only, so curly quotes / dashes / ellipses must be transliterated or
// they render as blanks. Also decodes the handful of XML entities Google News emits.
static void asciiClean(char* d, size_t cap, const char* s) {
  size_t o = 0;
  for (size_t i = 0; s[i] && o + 1 < cap; ) {
    unsigned char c = (unsigned char)s[i];
    if (c == '&') {
      if (!strncmp(s + i, "&amp;",  5)) { d[o++] = '&';  i += 5; continue; }
      if (!strncmp(s + i, "&quot;", 6)) { d[o++] = '"';  i += 6; continue; }
      if (!strncmp(s + i, "&#39;",  5)) { d[o++] = '\''; i += 5; continue; }
      if (!strncmp(s + i, "&apos;", 6)) { d[o++] = '\''; i += 6; continue; }
      if (!strncmp(s + i, "&lt;",   4)) { d[o++] = '<';  i += 4; continue; }
      if (!strncmp(s + i, "&gt;",   4)) { d[o++] = '>';  i += 4; continue; }
      d[o++] = '&'; i++; continue;
    }
    if (c < 0x80) { d[o++] = (char)c; i++; continue; }
    if (c == 0xE2 && (unsigned char)s[i + 1] == 0x80) {          // U+2018..U+2026
      unsigned char k = (unsigned char)s[i + 2];
      const char* r = (k == 0x98 || k == 0x99) ? "'" :
                      (k == 0x9C || k == 0x9D) ? "\"" :
                      (k == 0x93 || k == 0x94) ? "-" :
                      (k == 0xA6) ? "..." : "";
      while (*r && o + 1 < cap) d[o++] = *r++;
      i += 3; continue;
    }
    i++; while ((s[i] & 0xC0) == 0x80) i++;                      // skip other multibyte
  }
  d[o] = 0;
}
static time_t parseRFC822(const char* s) {                       // "Tue, 29 Sep 2026 13:50:00 GMT"
  static const char* MON = "JanFebMarAprMayJunJulAugSepOctNovDec";
  int d, y, h, mi, se; char mon[8];
  const char* c = strchr(s, ','); if (c) s = c + 1;
  while (*s == ' ') s++;
  if (sscanf(s, "%d %3s %d %d:%d:%d", &d, mon, &y, &h, &mi, &se) != 6) return 0;
  const char* q = strstr(MON, mon); if (!q) return 0;
  int mo = (int)((q - MON) / 3) + 1;
  int yy = y - (mo <= 2);
  long era = (yy >= 0 ? yy : yy - 399) / 400;
  unsigned yoe = (unsigned)(yy - era * 400);
  unsigned doy = (153 * (mo + (mo > 2 ? -3 : 9)) + 2) / 5 + d - 1;
  unsigned doe = yoe * 365 + yoe / 4 - yoe / 100 + doy;
  long days = era * 146097L + (long)doe - 719468L;
  return (time_t)(days * 86400L + h * 3600L + mi * 60L + se);    // feed stamps are GMT
}
bool fetchNews() {
  size_t len;
  if (!httpGetRaw(NEWS_URL, len, 16000)) return false;
  int n = 0;
  const char* p = bodyBuf;
  while (n < NEWS_MAX && (p = strstr(p, "<item>")) != nullptr) {
    const char* end = strstr(p, "</item>");
    const char* t   = strstr(p, "<title>");
    const char* te  = t ? strstr(t, "</title>") : nullptr;
    if (!t || !te || (end && t > end)) break;                    // truncated mid-item
    char raw[200];
    size_t l = (size_t)(te - (t + 7)); if (l >= sizeof raw) l = sizeof raw - 1;
    memcpy(raw, t + 7, l); raw[l] = 0;
    char clean[124];
    asciiClean(clean, sizeof clean, raw);
    // Google News always appends " - <source>", but the label varies (" - wsj.com", " - WSJ",
    // " - The Wall Street Journal"), so truncate at the LAST separator rather than matching names.
    for (char* q = clean + strlen(clean) - 3; q > clean; q--)
      if (q[0] == ' ' && q[1] == '-' && q[2] == ' ') { *q = 0; break; }
    if (!strstr(clean, "Print Edition") && clean[0]) {           // skip the daily index entry
      strlcpy(NEWS[n].title, clean, sizeof NEWS[n].title);
      const char* d = strstr(p, "<pubDate>");
      NEWS[n].t = (d && (!end || d < end)) ? parseRFC822(d + 9) : 0;
      n++;
    }
    if (!end) break;
    p = end + 7;
  }
  if (n == 0) { lastErr = "no items"; return false; }
  newsN = n; time(&newsAt);
  Serial.printf("news: %d headlines, top='%s'\n", newsN, NEWS[0].title);
  return true;
}

// ---------------- NWS alerts fetch ----------------
bool fetchAlerts() {
  char url[128];
  snprintf(url, sizeof url, "https://api.weather.gov/alerts/active?point=%.4f,%.4f", SITE_LAT, SITE_LON);
  JsonDocument filter;
  JsonObject pf = filter["features"][0]["properties"].to<JsonObject>();
  pf["event"] = true; pf["ends"] = true; pf["expires"] = true; pf["areaDesc"] = true;
  JsonDocument doc;
  if (!awGet(url, doc, filter)) return false;

  char ev[48] = "", ar[72] = ""; time_t en = 0; int rank = 0;
  for (JsonObject a : doc["features"].as<JsonArray>()) {
    const char* e = a["properties"]["event"] | "";
    if (!strstr(e, "Warning")) continue;                 // warnings only
    int r = strstr(e, "Tornado") ? 2 : (strstr(e, "Thunderstorm") ? 1 : 0);
    if (r <= rank) continue;                             // keep the most severe
    rank = r;
    strlcpy(ev, e, sizeof ev);
    strlcpy(ar, a["properties"]["areaDesc"] | "", sizeof ar);
    const char* t = a["properties"]["ends"] | "";
    if (!t[0]) t = a["properties"]["expires"] | "";
    en = parseISO(t);
  }
  bool was = alertActive; char prev[48]; strlcpy(prev, alertEvent, sizeof prev);
  alertRank = rank; alertActive = rank > 0;
  strlcpy(alertEvent, ev, sizeof alertEvent);
  strlcpy(alertArea,  ar, sizeof alertArea);
  alertEnds = en;
  if (alertActive != was || strcmp(prev, alertEvent) != 0) {
    if (alertActive) { curScreen = SCR_WEATHER; Serial.printf("*** ALERT: %s (%s) until %s\n", alertEvent, alertArea, fmtTime(alertEnds).c_str()); }
    else Serial.println("alert cleared");
    needRender = true;                                   // repaint immediately, don't wait for rotation
  }
  return true;
}
// An alert whose end time has passed is over even if the next poll hasn't run yet.
static bool alertLive() {
  if (!alertActive) return false;
  if (alertEnds > 0) { time_t n; time(&n); if (n > alertEnds) return false; }
  return true;
}

// ---------------- NWS forecast fetch ----------------
bool fetchForecast() {
  JsonDocument filter;
  JsonObject pf = filter["properties"]["periods"][0].to<JsonObject>();
  pf["name"] = true; pf["temperature"] = true; pf["isDaytime"] = true;
  pf["shortForecast"] = true; pf["detailedForecast"] = true;
  pf["windSpeed"] = true; pf["windDirection"] = true;
  pf["probabilityOfPrecipitation"]["value"] = true;
  JsonDocument doc;
  if (!awGet(NWS_URL, doc, filter)) return false;
  JsonArray ps = doc["properties"]["periods"];
  if (!ps.size()) { lastErr = "no periods"; return false; }
  fcN = 0;
  for (JsonObject o : ps) {
    if (fcN >= 5) break;
    Period& q = fc[fcN];
    strlcpy(q.name,   o["name"]          | "", sizeof q.name);
    strlcpy(q.shortF, o["shortForecast"] | "", sizeof q.shortF);
    const char* wsp = o["windSpeed"]     | "";
    const char* wdr = o["windDirection"] | "";
    snprintf(q.wind, sizeof q.wind, "%s %s", wsp, wdr);
    q.temp = o["temperature"] | 0;
    q.day  = o["isDaytime"]   | true;
    q.pop  = o["probabilityOfPrecipitation"]["value"] | 0;
    if (fcN == 0) strlcpy(fcDetail, o["detailedForecast"] | "", sizeof fcDetail);
    fcN++;
  }
  time(&fcAt);
  Serial.printf("forecast: %d periods, '%s' %dF %s\n", fcN, fc[0].name, fc[0].temp, fc[0].shortF);
  return true;
}

// ---------------- ComEd fetch ----------------
bool fetchComEd() {
  bool any = false;
  { JsonDocument filter; filter[0]["price"] = true; filter[0]["millisUTC"] = true;
    JsonDocument doc;
    if (awGet("https://hourlypricing.comed.com/api?type=currenthouraverage", doc, filter)) {
      JsonArray arr = doc.as<JsonArray>();
      if (arr.size()) {
        comedCur = atof(arr[0]["price"]  | "0");
        comedAt  = (time_t)(atof(arr[0]["millisUTC"] | "0") / 1000.0);
        any = true;
      }
    }
  }
  time_t now; time(&now); struct tm lt; localtime_r(&now, &lt);
  char url[96];
  snprintf(url, sizeof url, "https://hourlypricing.comed.com/api?type=day&date=%04d%02d%02d",
           lt.tm_year + 1900, lt.tm_mon + 1, lt.tm_mday);
  size_t len;
  if (httpGetRaw(url, len)) {
    for (int i = 0; i < 24; i++) comedHour[i] = NAN;
    comedN = 0;
    const char* q = bodyBuf;
    while ((q = strstr(q, "Date.UTC(")) != nullptr) {
      q += 9;
      int y, mo, d, h, mi, se;
      if (sscanf(q, "%d,%d,%d,%d,%d,%d", &y, &mo, &d, &h, &mi, &se) == 6) {
        const char* r = strchr(q, ')');
        if (r) { r++; while (*r == ',' || *r == ' ') r++;
                 int slot = h - 1;              // hour-ending -> hour-starting
                 if (slot >= 0 && slot < 24) { comedHour[slot] = atof(r); comedN++; } }
      }
    }
    Serial.printf("ComEd: cur %.1fc, %d hourly averages today\n", comedCur, comedN);
    any = true;
  }
  if (!any) Serial.printf("ComEd failed: %s\n", lastErr.c_str());
  return any;
}

// Page back through today's history accumulating hi/lo. Stops once it crosses local midnight.
void backfillDayHiLo() {
  time_t now; time(&now);
  if (now < 1000000000) return;                       // wait for NTP
  struct tm lt; localtime_r(&now, &lt);
  int key = lt.tm_yday;
  struct tm mid = lt; mid.tm_hour = 0; mid.tm_min = 0; mid.tm_sec = 0; mid.tm_isdst = -1;
  time_t midnight = mktime(&mid);
  dayHi = dayLo = NAN; dayHiT = dayLoT = 0;
  // endDate is epoch MILLISECONDS (13 digits, > 32 bits). ESP32's newlib-nano printf has no
  // %lld, so format the SECONDS with %lu and tack on the three zeros.
  unsigned long endSec = (unsigned long)now;
  JsonDocument filter;
  filter[0]["dateutc"] = true; filter[0]["tempf"] = true;
  int c = 0;
  delay(1400);                       // AWN allows ~1 req/s and we just did history + current
  for (; c < 7; c++) {
    char url[384];
    snprintf(url, sizeof url,
             "https://rt.ambientweather.net/v1/devices/%s?apiKey=%s&applicationKey=%s&limit=48&endDate=%lu000",
             AW_MAC, AW_API_KEY, AW_APP_KEY, endSec);
    JsonDocument doc;
    bool got = false;
    for (int a = 0; a < 3 && !got; a++) {          // 429 is common here - back off and retry
      if (a) delay(2500);
      got = awGet(url, doc, filter);
    }
    if (!got) break;
    JsonArray arr = doc.as<JsonArray>();
    if (!arr.size()) break;
    unsigned long oldestSec = endSec;
    for (JsonObject o : arr) {
      double ms = o["dateutc"] | 0.0;
      float t = o["tempf"] | NAN;
      if (ms <= 0) continue;
      unsigned long sec = (unsigned long)(ms / 1000.0);
      if (sec < oldestSec) oldestSec = sec;
      if ((time_t)sec < midnight || isnan(t)) continue;
      if (isnan(dayHi) || t > dayHi) { dayHi = t; dayHiT = (time_t)sec; }
      if (isnan(dayLo) || t < dayLo) { dayLo = t; dayLoT = (time_t)sec; }
    }
    if (oldestSec <= (unsigned long)midnight) { c++; break; }
    endSec = oldestSec - 1;
    delay(1200);                                      // AWN allows ~1 request/second
  }
  dayKey = key;
  Serial.printf("day hi/lo: %.1f at %s / %.1f at %s (%d chunks)\n",
                dayHi, fmtTime(dayHiT).c_str(), dayLo, fmtTime(dayLoT).c_str(), c);
}

static bool tryN(bool (*fn)(), const char* what, int tries = 3) {
  for (int a = 0; a < tries; a++) { fetchTotal++; if (fn()) { fetchOk++; return true; } delay(1200); }
  Serial.printf("%s failed: %s\n", what, lastErr.c_str());
  return false;
}


// ---------------- e-paper drawing (800x480 landscape, B/W/R/Y) ----------------
// Layout constants: 20 px margins, header rule at y=60, footer baseline at y=468, and the
// banner/alert region of the weather screen at 316..444.
const int M = 20, FOOT_Y = 468, BAN_Y = 316, BAN_H = 128;

// Text helpers: GFX fonts draw from a baseline; use bounds for right/center alignment.
static int16_t textW(const String& s) { int16_t x, y; uint16_t w, h; display.getTextBounds(s, 0, 0, &x, &y, &w, &h); return w; }
static void txt(int x, int y, const String& s, const GFXfont* f, uint16_t col = C_BLACK, uint8_t size = 1) {
  display.setFont(f); display.setTextSize(size);
  if (col == C_YELLOW) {                 // yellow on white is faint: ring it in black first
    display.setTextColor(C_BLACK);
    for (int dy = -1; dy <= 1; dy++) for (int dx = -1; dx <= 1; dx++)
      if (dx || dy) { display.setCursor(x + dx, y + dy); display.print(s); }
  }
  display.setTextColor(col); display.setCursor(x, y); display.print(s);
}
static void txtR(int xr, int y, const String& s, const GFXfont* f, uint16_t col = C_BLACK, uint8_t size = 1) {
  display.setFont(f); display.setTextSize(size); txt(xr - textW(s), y, s, f, col, size);
}
static void txtC(int xc, int y, const String& s, const GFXfont* f, uint16_t col = C_BLACK, uint8_t size = 1) {
  display.setFont(f); display.setTextSize(size); txt(xc - textW(s) / 2, y, s, f, col, size);
}
static void label(int x, int y, const char* s) { txt(x, y, s, &FreeSans9pt7b); }
static void degSign(int x, int y, int r, uint16_t col) { display.drawCircle(x, y, r, col); display.drawCircle(x, y, r - 1, col); }
// Band word after a big number: 18 pt if it fits before maxRight, else 12 pt.
static void bandTxt(int x, int y, const String& s, uint16_t col, int maxRight) {
  display.setFont(&FreeSansBold18pt7b); display.setTextSize(1);
  txt(x, y, s, x + textW(s) <= maxRight ? &FreeSansBold18pt7b : &FreeSansBold12pt7b, col);
}
// Filled bar; yellow bars get a black outline so they read on white.
static void bar(int x, int y, int w, int h, uint16_t c) {
  display.fillRect(x, y, w, h, c);
  if (c == C_YELLOW && w > 2 && h > 2) display.drawRect(x, y, w, h, C_BLACK);
}
static void header(const String& title, time_t now, bool eastern = false) {
  display.fillScreen(C_WHITE);
  display.setTextWrap(false);          // never wrap: an overflowing label would orphan chars at x=0
  txt(M, 46, title, &FreeSansBold24pt7b);
  // News runs on EASTERN (market time, and Bradley's clients' zone); ET = CT + 1 h year round.
  txtR(SCR_W - M, 46, eastern ? fmtTime(now + 3600, "%a %b %e   %l:%M %p") + " ET"
                               : fmtTime(now, "%a %b %e   %l:%M %p"), &FreeSans12pt7b);
  display.fillRect(M, 60, SCR_W - 2 * M, 3, C_BLACK);
}
static void footer(const String& left, const String& right = "", uint16_t rcol = C_BLACK) {
  txt(M, FOOT_Y, left, &FreeSans9pt7b);
  if (right.length()) txtR(SCR_W - M, FOOT_Y, right, &FreeSans9pt7b, rcol);
}
// Caution tiers (yellow) between normal (black) and alert (red).
static uint16_t pollenCol(float v) { if (isnan(v)) return C_BLACK; return v >= 7.3f ? C_RED : v >= 4.9f ? C_YELLOW : C_BLACK; }
static uint16_t aqiCol(int a)      { return a > 100 ? C_RED : a > 50 ? C_YELLOW : C_BLACK; }
static uint16_t kpCol(float k)     { if (isnan(k)) return C_BLACK; return k >= 5 ? C_RED : k >= 4 ? C_YELLOW : C_BLACK; }
static uint16_t magCol(float m)    { return m >= 6 ? C_RED : m >= 5 ? C_YELLOW : C_BLACK; }

static void drawArrow(int cx, int cy, float d, uint16_t col) {
  if (isnan(d) || fabs(d) < TREND_MB) { display.fillRect(cx - 18, cy - 3, 36, 6, col); return; }
  if (d > 0) display.fillTriangle(cx - 20, cy + 18, cx + 20, cy + 18, cx, cy - 20, col);
  else       display.fillTriangle(cx - 20, cy - 18, cx + 20, cy - 18, cx, cy + 20, col);
}
static void drawBolt(int x, int y, uint16_t col) {   // ~16x28 lightning bolt
  display.fillTriangle(x + 9, y, x + 1, y + 16, x + 9, y + 15, col);
  display.fillTriangle(x + 9, y + 12, x + 7, y + 28, x + 15, y + 11, col);
}
static void hiLoBlock(int x, int y, const char* lab, float v, time_t t) {
  txt(x, y, lab, &FreeSans9pt7b);
  String sv = isnan(v) ? "--" : f0(v);
  txt(x, y + 38, sv, &FreeSansBold18pt7b);
  display.setFont(&FreeSansBold18pt7b); display.setTextSize(1);
  int w = textW(sv);
  if (!isnan(v)) degSign(x + w + 7, y + 22, 4, C_BLACK);
  if (t) txt(x + w + 18, y + 38, fmtTime(t), &FreeSans9pt7b);
}
static void statBlockSm(int x, int y, const char* lab, String val, uint16_t col = C_BLACK) {
  label(x, y, lab);
  txt(x, y + 30, val, &FreeSansBold12pt7b, col);
}
// A trailing '~' in val means "draw a degree sign here" (the GFX fonts are ASCII-only).
static void statBlock(int x, int y, const char* lab, String val, uint16_t col = C_BLACK) {
  label(x, y, lab);
  bool deg = val.endsWith("~");
  if (deg) val.remove(val.length() - 1);
  txt(x, y + 34, val, &FreeSansBold18pt7b, col);
  if (deg) { display.setFont(&FreeSansBold18pt7b); display.setTextSize(1); degSign(x + textW(val) + 8, y + 16, 4, col); }
}

// Message markup: *words* are RED, ~words~ are YELLOW; everything else black.
static String stripMarks(const String& s) { String o = s; o.replace("*", ""); o.replace("~", ""); return o; }

// Word-wrap s (spaces and explicit '\n') into out[] for the given font/size within maxW px.
// Widths are measured with the markers removed so markup never changes the wrapping.
static int wrapText(const String& s, const GFXfont* f, uint8_t size, int maxW, String out[], int maxLines) {
  display.setFont(f); display.setTextSize(size);
  int n = 0; String line;
  int i = 0, len = s.length();
  while (i <= len && n < maxLines) {
    int j = i; while (j < len && s[j] != ' ' && s[j] != '\n') j++;
    String word = s.substring(i, j);
    String cand = line.length() ? line + " " + word : word;
    if (textW(stripMarks(cand)) > maxW && line.length()) { out[n++] = line; line = word; }
    else line = cand;
    if (j >= len) { if (line.length() && n < maxLines) out[n++] = line; break; }
    if (s[j] == '\n') { if (n < maxLines) out[n++] = line; line = ""; }
    i = j + 1;
  }
  return n;
}
// Draw one wrapped line, toggling color at each marker. `col` carries the state across lines.
static void drawMarkupLine(int x, int y, const String& line, const GFXfont* f, uint8_t size, uint16_t& col) {
  int start = 0;
  for (int i = 0; i <= (int)line.length(); i++) {
    bool end = i == (int)line.length();
    char c = end ? 0 : line[i];
    if (end || c == '*' || c == '~') {
      String seg = line.substring(start, i);
      if (seg.length()) {
        txt(x, y, seg, f, col, size);
        x = display.getCursorX();          // cursor advance keeps the trailing space; ink width (textW) drops it
      }
      if (!end) {
        if (c == '*') col = (col == C_RED)    ? C_BLACK : C_RED;
        else          col = (col == C_YELLOW) ? C_BLACK : C_YELLOW;
      }
      start = i + 1;
    }
  }
}
static String msgExpiryText() {
  if (!msgTtlMs) return "until cleared";
  long left = (long)(msgTtlMs - (millis() - msgSetMs)) / 60000L;
  if (left < 1) return "expiring";
  return left < 60 ? String(left) + " min left" : String(left / 60) + " h " + String(left % 60) + " min left";
}
static void drawFullMessage(time_t now) {
  const int bx = M, by = 72, bw = SCR_W - 2 * M, bh = FOOT_Y - 26 - by;      // 72..442
  display.drawRect(bx, by, bw, bh, C_RED);
  display.drawRect(bx + 2, by + 2, bw - 4, bh - 4, C_RED);
  String lines[10]; int n; uint8_t size = 2; int lh = 78;
  n = wrapText(msgText, &FreeSansBold24pt7b, 2, bw - 60, lines, 10);
  if (n > 4) { size = 1; lh = 44; n = wrapText(msgText, &FreeSansBold24pt7b, 1, bw - 60, lines, 8); }
  int y0 = by + (bh - n * lh) / 2 + lh - (size == 2 ? 14 : 8);
  uint16_t col = C_BLACK;
  for (int i = 0; i < n; i++) {
    display.setFont(&FreeSansBold24pt7b); display.setTextSize(size);
    int x = SCR_W / 2 - textW(stripMarks(lines[i])) / 2;
    drawMarkupLine(x, y0 + i * lh, lines[i], &FreeSansBold24pt7b, size, col);
  }
  display.setTextSize(1);
  footer("Message  -  " + msgExpiryText() + "     " + fmtTime(now),
         f0(cur.tempf) + " F   " + f1(cur.baromRel) + " mb");
}
static void drawBannerMessage() {
  const int bx = M, by = BAN_Y, bw = SCR_W - 2 * M, bh = BAN_H;
  display.drawRect(bx, by, bw, bh, C_RED);
  display.drawRect(bx + 1, by + 1, bw - 2, bh - 2, C_RED);
  display.fillRect(bx, by, 10, bh, C_RED);
  String lines[4]; int n = wrapText(msgText, &FreeSansBold18pt7b, 1, bw - 56, lines, 3);
  int y0 = by + 36 + ((bh - 28) - n * 34) / 2;
  uint16_t col = C_BLACK;
  for (int i = 0; i < n; i++) drawMarkupLine(bx + 26, y0 + i * 34, lines[i], &FreeSansBold18pt7b, 1, col);
  txtR(bx + bw - 10, by + bh - 8, msgExpiryText(), &FreeSans9pt7b, C_RED);
}

// Thousands separators, used by the river (streamflow) and quake (distance) screens.
static String grpAbs(double v){                     // 1234567 -> "1,234,567"
  char b[24]; snprintf(b,sizeof b,"%ld",(long)llround(fabs(v)));
  String d(b), o; int c=0;
  for (int i=d.length()-1;i>=0;i--){ o = String(d[i]) + o; if(++c%3==0 && i>0) o = "," + o; }
  return o;
}

// ---------------- WSJ headlines drawing ----------------
void drawNews() {
  time_t now; time(&now);
  header("Wall Street Journal", now, true);
  if (newsN == 0) {
    txtC(SCR_W / 2, 240, "Headlines unavailable", &FreeSansBold18pt7b, C_RED);
    footer("news.google.com");
    return;
  }
  int y = 96;
  for (int i = 0; i < newsN; i++) {
    String ln[2];
    int n = wrapText(NEWS[i].title, &FreeSans12pt7b, 1, SCR_W - 100 - M, ln, 2);
    if (y + (n - 1) * 24 > 444) break;                       // would run into the footer
    if (NEWS[i].t) txt(M, y, agoStr(NEWS[i].t, now), &FreeSans9pt7b);
    for (int k = 0; k < n; k++) txt(100, y + k * 24, ln[k], &FreeSans12pt7b);
    y += n * 24 + 12;
  }
  footer("WSJ headlines via news.google.com    updated " + fmtTime(newsAt + 3600) + " ET",
         String(newsN) + " stories");
}

// ---------------- river / quakes / space drawing ----------------
static const char* kpBand(float k) {
  if (isnan(k)) return "";
  if (k < 3) return "Quiet";      if (k < 4) return "Unsettled";
  if (k < 5) return "Active";     if (k < 6) return "G1 storm";
  if (k < 7) return "G2 storm";   if (k < 8) return "G3 storm";
  if (k < 9) return "G4 severe";
  return "G5 extreme";
}
void drawRiver() {
  time_t now; time(&now);
  header(RIVER_NAME, now);

  // yellow from action stage, red from flood (minor) stage
  uint16_t sc = isnan(rivStage) ? C_BLACK : rivStage >= FLOOD_MINOR ? C_RED
              : rivStage >= FLOOD_ACTION ? C_YELLOW : C_BLACK;
  label(M, 82, "GAGE HEIGHT");
  String sv = isnan(rivStage) ? "--" : String(rivStage, 2);
  txt(16, 150, sv, &FreeSansBold24pt7b, sc, 2);
  display.setFont(&FreeSansBold24pt7b); display.setTextSize(2);
  int sw = textW(sv); display.setTextSize(1);
  txt(16 + sw + 16, 150, "ft", &FreeSansBold18pt7b, sc);
  if (!isnan(rivStage) && rivStage >= FLOOD_ACTION)
    txt(16, 174, rivStage >= FLOOD_MAJOR ? "MAJOR FLOODING" : rivStage >= FLOOD_MODERATE ? "MODERATE FLOODING"
                 : rivStage >= FLOOD_MINOR ? "MINOR FLOODING" : "ABOVE ACTION STAGE", &FreeSansBold12pt7b, sc);

  label(384, 82, "STREAMFLOW");
  String fv = isnan(rivFlow) ? "--" : grpAbs(rivFlow);
  txt(380, 150, fv, &FreeSansBold24pt7b, C_BLACK, 2);
  display.setFont(&FreeSansBold24pt7b); display.setTextSize(2);
  int fw = textW(fv); display.setTextSize(1);
  txt(380 + fw + 16, 150, "ft3/s", &FreeSansBold18pt7b);

  if (!isnan(rivStage) && !isnan(rivFirst)) {
    float d = rivStage - rivFirst;
    String t = (d > 0 ? "+" : "") + String(d, 2) + " ft in 24 h";
    txt(M, 194, (d > 0.02f ? "RISING    " : d < -0.02f ? "FALLING    " : "STEADY    ") + t,
        &FreeSans12pt7b, d > 0.02f ? C_RED : C_BLACK);
  }
  display.fillRect(M, 210, SCR_W - 2 * M, 2, C_BLACK);

  // Laid out like the official NWS/AHPS hydrograph for this gauge: a FIXED stage window that
  // always shows every flood category, tinted bands between them, and the thresholds labelled
  // on the chart. Auto-scaling to the data hid moderate/major and made a normal 5.6 ft look full.
  label(M, 234, "STAGE (ft)     OBSERVED, LAST 24 HOURS");
  const int X0 = 72, X1 = SCR_W - M, Y0 = 248, Y1 = 424;
  if (rivHistN >= 2) {
    float mn = 1e9, mx = -1e9;
    for (int i = 0; i < rivHistN; i++) { mn = min(mn, rivHist[i]); mx = max(mx, rivHist[i]); }
    float lo = min(4.0f, mn - 0.5f);                    // AHPS plots this gauge from 4 ft
    float hi = max(FLOOD_MAJOR + 1.5f, mx + 0.5f);      // 12.5 clears the 12.1 ft record
    auto yOf = [&](float v){ return (int)(Y1 - (v - lo) / (hi - lo) * (Y1 - Y0)); };

    // Tinted category bands. Hatched rather than solid: a filled red block would dominate the
    // whole screen on a 4-colour panel, where AHPS can use a pale wash.
    auto hatch = [&](float from, float to, uint16_t c) {
      int ya = yOf(min(to, hi)), yb = yOf(max(from, lo));
      for (int y = ya; y <= yb; y += 3) display.drawFastHLine(X0, y, X1 - X0, c);
    };
    hatch(FLOOD_ACTION, FLOOD_MODERATE, C_YELLOW);      // action + minor
    hatch(FLOOD_MODERATE, hi,           C_RED);         // moderate + major

    display.drawFastVLine(X0 - 6, Y0, Y1 - Y0, C_BLACK);
    display.drawFastHLine(X0 - 6, Y1, X1 - X0 + 6, C_BLACK);
    for (int v = ((int)lo / 2) * 2; v <= (int)hi; v += 2) {       // stage ticks every 2 ft
      int gy = yOf((float)v);
      if (gy < Y0 - 2 || gy > Y1) continue;
      display.drawFastHLine(X0 - 11, gy, 5, C_BLACK);
      txtR(X0 - 13, gy + 5, String(v), &FreeSans9pt7b);
    }

    struct Th { float v; const char* n; };
    const Th TH[] = { {FLOOD_MAJOR, "Major: 11 ft"}, {FLOOD_MODERATE, "Moderate: 9 ft"},
                      {FLOOD_MINOR, "Minor: 7 ft"},  {FLOOD_ACTION, "Action: 6.5 ft"} };
    for (const Th& t : TH) {
      if (t.v < lo || t.v > hi) continue;
      int ty = yOf(t.v);
      display.drawFastHLine(X0, ty, X1 - X0, C_BLACK);
      txt(X0 + 6, ty - 5, t.n, &FreeSans9pt7b, C_BLACK);
    }

    int px = -1, py = -1;                                // observed trace
    for (int i = 0; i < rivHistN; i++) {
      int gx = X0 + (int)((float)i / (rivHistN - 1) * (X1 - X0));
      int gy = yOf(rivHist[i]);
      if (px >= 0) { display.drawLine(px, py, gx, gy, C_BLACK);
                     display.drawLine(px, py + 1, gx, gy + 1, C_BLACK);
                     display.drawLine(px, py - 1, gx, gy - 1, C_BLACK); }
      px = gx; py = gy;
    }
    display.fillCircle(px, py, 5, C_RED);

    // x axis: the window is exactly 24 h ending at rivAt, so times come from the index
    for (int k = 0; k <= 4; k++) {
      int i = k * (rivHistN - 1) / 4;
      int gx = X0 + (int)((float)i / (rivHistN - 1) * (X1 - X0));
      time_t tt = rivAt - (time_t)((double)(rivHistN - 1 - i) / (rivHistN - 1) * 86400.0);
      display.drawFastVLine(gx, Y1 + 1, 5, C_BLACK);
      struct tm lt; localtime_r(&tt, &lt);
      char d[8]; strftime(d, sizeof d, "%a", &lt);
      int hh = lt.tm_hour % 12; if (!hh) hh = 12;
      char lbl[16]; snprintf(lbl, sizeof lbl, "%s %d%c", d, hh, lt.tm_hour < 12 ? 'a' : 'p');
      txtC(gx, Y1 + 20, lbl, &FreeSans9pt7b);
    }
  } else txtC(SCR_W / 2, 340, "no history", &FreeSans12pt7b);

  // action + flood are on the chart; the footer only needs the two upper stages (the long
  // version collided with "updated" - photo 6 Oct 2026)
  footer(String("USGS ") + USGS_SITE + "    NWSLI " RIVER_NWSLI "    updated " + fmtTime(rivAt),
         "observed, last 24 h");
}
void drawQuakes() {
  time_t now; time(&now);
  header("Earthquakes", now);
  if (qkN == 0) { txtC(SCR_W / 2, 240, "No US quakes in the past 24 hours", &FreeSansBold18pt7b);
                  footer("earthquake.usgs.gov"); return; }
  label(M, 82, "EVENTS");    txt(M, 118, String(qkTotal), &FreeSansBold18pt7b);
  label(140, 82, "LARGEST"); txt(140, 118, "M" + String(qkBig, 1), &FreeSansBold18pt7b, magCol(qkBig));
  label(280, 82, "NEAREST"); txt(280, 118, grpAbs(QK[0].dist) + " mi", &FreeSansBold18pt7b,
                                 QK[0].dist < 300 ? C_RED : C_BLACK);
  txtR(SCR_W - M, 82, "US, M2.5+, PAST 24 H, NEAREST FIRST", &FreeSans9pt7b);
  display.drawFastHLine(M, 136, SCR_W - 2 * M, C_BLACK);
  int y = 166;
  for (int i = 0; i < qkN && y < 430; i++, y += 40) {
    uint16_t c = magCol(QK[i].mag);
    txt(M, y, "M" + String(QK[i].mag, 1), &FreeSansBold18pt7b, c);
    String pl[1]; wrapText(QK[i].place, &FreeSans12pt7b, 1, 440, pl, 1);
    txt(130, y, pl[0], &FreeSans12pt7b);
    txtR(690, y, grpAbs(QK[i].dist) + " mi", &FreeSans12pt7b,
         QK[i].dist < 300 ? C_RED : C_BLACK);
    if (QK[i].t) txtR(SCR_W - M, y, agoStr(QK[i].t, now), &FreeSans9pt7b);
  }
  footer("earthquake.usgs.gov    updated " + fmtTime(qkAt));
}
void drawSpace() {
  time_t now; time(&now);
  header("Space Weather", now);

  uint16_t kc = kpCol(kpNow);
  label(M, 82, "PLANETARY Kp   0-9");
  String kv = isnan(kpNow) ? "--" : String(kpNow, 1);
  txt(16, 154, kv, &FreeSansBold24pt7b, kc, 2);
  display.setFont(&FreeSansBold24pt7b); display.setTextSize(2);
  int kw = textW(kv); display.setTextSize(1);
  bandTxt(16 + kw + 18, 154, kpBand(kpNow), kc, 420);
  // Northern Illinois sits near 42 N - aurora needs a severe storm to reach this far south.
  bool aur = !isnan(kpNow) && kpNow >= 7;
  label(430, 82, "AURORA AT THIS LATITUDE");
  txt(430, 122, aur ? "POSSIBLE TONIGHT" : "Not likely", &FreeSansBold18pt7b, aur ? C_RED : C_BLACK);
  txt(430, 156, "needs about Kp 7 to reach 42 N", &FreeSans9pt7b);
  display.fillRect(M, 192, SCR_W - 2 * M, 2, C_BLACK);

  label(M, 216, "PLANETARY Kp, LAST 3 DAYS  (3-hourly)");
  const int X0 = 52, X1 = SCR_W - M, Y0 = 232, Y1 = 428;
  auto yOf = [&](float v){ return (int)(Y1 - (v / 9.0f) * (Y1 - Y0)); };
  display.drawFastVLine(X0 - 6, Y0, Y1 - Y0, C_BLACK);
  for (int g = 0; g <= 9; g += 3) {
    int gy = yOf((float)g);
    for (int x = X0; x < X1; x += 8) display.drawPixel(x, gy, g >= 5 ? C_RED : C_BLACK);
    txtR(X0 - 10, gy + 5, String(g), &FreeSans9pt7b, g >= 5 ? C_RED : C_BLACK);
  }
  int sy = yOf(5);
  display.drawFastHLine(X0, sy, X1 - X0, C_RED);
  txtR(X1, sy - 6, "Kp 5 = storm", &FreeSans9pt7b, C_RED);
  display.drawFastHLine(X0, Y1, X1 - X0, C_BLACK);
  if (kpHistN > 0) {
    float step = (float)(X1 - X0) / (float)kpHistN;
    for (int i = 0; i < kpHistN; i++) {
      int bx = X0 + (int)(i * step) + 3, bw = (int)step - 6; if (bw < 3) bw = 3;
      int vy = yOf(kpHist[i]);
      bar(bx, vy, bw, Y1 - vy, kpCol(kpHist[i]));
    }
    // x axis: tick + local day/hour under every 4th sample, i.e. every 12 h
    for (int i = 0; i < kpHistN; i += 4) {
      if (!kpTime[i]) continue;
      int cx = X0 + (int)(i * step) + (int)(step / 2);
      display.drawFastVLine(cx, Y1 + 1, 5, C_BLACK);
      struct tm lt; localtime_r(&kpTime[i], &lt);
      char d[8]; strftime(d, sizeof d, "%a", &lt);
      int hh = lt.tm_hour % 12; if (!hh) hh = 12;
      char lbl[16]; snprintf(lbl, sizeof lbl, "%s %d%c", d, hh, lt.tm_hour < 12 ? 'a' : 'p');
      txtC(cx, Y1 + 20, lbl, &FreeSans9pt7b);
    }
  }
  footer("services.swpc.noaa.gov    updated " + fmtTime(kpAt), "times are local");
}

// ---------------- air & allergy drawing ----------------
void drawAir() {
  time_t now; time(&now);
  header("Air & Allergy", now);

  // ---- pollen, left ----
  uint16_t pc = pollenCol(pollenIdx);
  label(M, 82, "POLLEN TODAY   index 0-12");
  String pv = isnan(pollenIdx) ? "--" : f1(pollenIdx);
  txt(16, 150, pv, &FreeSansBold24pt7b, pc, 2);
  display.setFont(&FreeSansBold24pt7b); display.setTextSize(2);
  int pw = textW(pv); display.setTextSize(1);
  bandTxt(16 + pw + 18, 150, pollenBand(pollenIdx), pc, 396);
  label(M, 188, "TOP ALLERGENS");
  if (pollenTrig[0]) {
    String tl[2];
    int tn = wrapText(pollenTrig, &FreeSans12pt7b, 1, 360, tl, 2);
    for (int k = 0; k < tn; k++) txt(M, 218 + k * 24, tl[k], &FreeSans12pt7b);
  } else txt(M, 218, "--", &FreeSans12pt7b);

  display.drawFastVLine(404, 72, 196, C_BLACK);

  // ---- air quality, right ----
  uint16_t ac = aqiCol(aqiVal);
  label(424, 82, "AIR QUALITY   US AQI");
  String av = aqiVal < 0 ? "--" : String(aqiVal);
  txt(420, 150, av, &FreeSansBold24pt7b, ac, 2);
  display.setFont(&FreeSansBold24pt7b); display.setTextSize(2);
  int aw = textW(av); display.setTextSize(1);
  if (aqiVal >= 0) bandTxt(420 + aw + 18, 150, aqiBand(aqiVal), ac, SCR_W - M);
  statBlockSm(424, 188, "PM2.5 ug/m3", f1(pm25));
  statBlockSm(546, 188, "PM10 ug/m3",  f1(pm10));
  statBlockSm(668, 188, "OZONE ug/m3", f0(ozone));

  display.fillRect(M, 270, SCR_W - 2 * M, 2, C_BLACK);

  // ---- asthma, lower left ----
  uint16_t asc = pollenCol(asthmaIdx);
  label(M, 294, "ASTHMA INDEX");
  txt(16, 354, isnan(asthmaIdx) ? "--" : f1(asthmaIdx), &FreeSansBold24pt7b, asc, 2);
  txt(M, 386, pollenBand(asthmaIdx), &FreeSans12pt7b, asc);

  // ---- 5-day pollen forecast, lower right ----
  // Bars stop 104 px short of the right edge so the "7.3 med-high" caption has its own lane, and
  // each value label gets a white backing so it reads cleanly where it crosses the dashed line
  // (photo 6 Oct 2026: "5.9" sat on the line and the caption collided with the last bar).
  label(300, 294, "POLLEN FORECAST, NEXT 5 DAYS");
  const int X0 = 300, X1 = SCR_W - M, XB = X1 - 104, Y0 = 318, Y1 = 416;
  float step = (float)(XB - X0) / 5.0f;
  auto yOf = [&](float v){ return (int)(Y1 - (v / 12.0f) * (Y1 - Y0)); };
  int ty = yOf(7.3f);                                   // Med-High threshold = red from here up
  for (int x = X0; x < XB + 6; x += 10) display.drawFastHLine(x, ty, 5, C_RED);
  txt(XB + 10, ty + 5, "7.3 med-high", &FreeSans9pt7b, C_RED);
  display.drawFastHLine(X0, Y1, XB - X0, C_BLACK);
  display.setFont(&FreeSans9pt7b); display.setTextSize(1);
  for (int i = 0; i < pollen5N; i++) {
    if (isnan(pollen5[i])) continue;
    int bx = X0 + (int)(i * step) + 10, bw = (int)step - 20;
    int vy = yOf(pollen5[i]);
    uint16_t c = pollenCol(pollen5[i]);                 // black < 4.9, yellow Medium, red >= 7.3
    bar(bx, vy, bw, Y1 - vy, c);
    String vs = f1(pollen5[i]); int vw = textW(vs);
    display.fillRect(bx + bw / 2 - vw / 2 - 3, vy - 20, vw + 6, 16, C_WHITE);   // backing over the dashed line
    txtC(bx + bw / 2, vy - 6, vs, &FreeSans9pt7b, c == C_YELLOW ? C_BLACK : c);
    char d[12]; snprintf(d, sizeof d, "%d/%d", p5mon[i], p5day[i]);
    txtC(bx + bw / 2, Y1 + 18, d, &FreeSans9pt7b);
  }

  footer(String("pollen.com ") + POLLEN_ZIP + "    open-meteo    updated " + fmtTime(airAt),
         "no mold data for this area");
}

// ---------------- alert box ----------------
void drawAlertBox() {
  const int bx = M, by = BAN_Y, bw = SCR_W - 2 * M, bh = BAN_H;
  int thick = (alertRank >= 2) ? 6 : 3;                  // tornado gets a heavier frame
  for (int i = 0; i < thick; i++) display.drawRect(bx + i, by + i, bw - 2 * i, bh - 2 * i, C_RED);
  String ln[2];
  int n = wrapText(alertEvent, &FreeSansBold24pt7b, 1, bw - 48, ln, 2);
  for (int k = 0; k < n; k++) txt(bx + 24, by + 44 + k * 38, ln[k], &FreeSansBold24pt7b, C_RED);
  int y = by + 44 + n * 38 + 22;
  if (y > by + bh - 12) y = by + bh - 12;
  txt(bx + 24, y, alertArea, &FreeSans12pt7b);
  if (alertEnds > 0) txtR(bx + bw - 24, y, "until " + fmtTime(alertEnds), &FreeSans12pt7b, C_RED);
}

// ---------------- forecast drawing ----------------
void drawForecast() {
  time_t now; time(&now);
  header("Forecast", now);
  if (fcN == 0) {
    txtC(SCR_W / 2, 240, "Forecast unavailable", &FreeSansBold18pt7b, C_RED);
    footer("api.weather.gov");
    return;
  }
  const int COLW = 152, X0 = M;
  for (int i = 0; i < fcN; i++) {
    int x = X0 + i * COLW;
    if (i) display.drawFastVLine(x - 10, 74, 214, C_BLACK);
    txt(x, 88, fc[i].name, &FreeSans9pt7b);
    String t = String(fc[i].temp);
    txt(x, 132, t, &FreeSansBold24pt7b);
    display.setFont(&FreeSansBold24pt7b); display.setTextSize(1);
    degSign(x + textW(t) + 9, 112, 5, C_BLACK);
    txt(x, 156, fc[i].day ? "HIGH" : "LOW", &FreeSans9pt7b);
    String ln[3];
    int n = wrapText(fc[i].shortF, &FreeSans9pt7b, 1, COLW - 18, ln, 3);
    for (int k = 0; k < n; k++) txt(x, 184 + k * 19, ln[k], &FreeSans9pt7b);
    if (fc[i].pop > 0)
      txt(x, 250, String(fc[i].pop) + "% precip", &FreeSans9pt7b,
          fc[i].pop >= 50 ? C_RED : C_BLACK);
    txt(x, 272, fc[i].wind, &FreeSans9pt7b);
  }
  display.fillRect(M, 292, SCR_W - 2 * M, 2, C_BLACK);

  label(M, 316, fc[0].name);
  String dl[4];
  int dn = wrapText(fcDetail, &FreeSans12pt7b, 1, SCR_W - 2 * M, dl, 4);
  for (int k = 0; k < dn; k++) txt(M, 344 + k * 24, dl[k], &FreeSans12pt7b);

  footer("api.weather.gov    updated " + fmtTime(fcAt), SITE_NAME "   grid " NWS_GRID);
}

// ---------------- ComEd drawing ----------------
static String hourLab(int h){ int hh = h % 12; if (!hh) hh = 12; return String(hh) + (h < 12 ? "a" : "p"); }

void drawComEd() {
  time_t now; time(&now); struct tm lt; localtime_r(&now, &lt);
  header("ComEd Hourly Pricing", now);

  float lo = 1e9, hi = -1e9, sum = 0; int n = 0, loH = 0, hiH = 0;
  for (int h = 0; h < 24; h++) if (!isnan(comedHour[h])) {
    if (comedHour[h] < lo) { lo = comedHour[h]; loH = h; }
    if (comedHour[h] > hi) { hi = comedHour[h]; hiH = h; }
    sum += comedHour[h]; n++;
  }
  float avg = n ? sum / n : NAN;

  bool curHigh = !isnan(comedCur) && comedCur >= ALERT_C;
  label(M, 82, "CURRENT HOUR AVERAGE");
  String cs = isnan(comedCur) ? "--" : f1(comedCur);
  txt(16, 160, cs, &FreeSansBold24pt7b, curHigh ? C_RED : C_BLACK, 2);
  display.setFont(&FreeSansBold24pt7b); display.setTextSize(2);
  int cx = 16 + textW(cs) + 16; display.setTextSize(1);
  txt(cx, 160, "c/kWh", &FreeSansBold18pt7b, curHigh ? C_RED : C_BLACK);

  statBlock(470, 82, "TODAY LOW", n ? f1(lo) + "c" : "--");
  statBlock(600, 82, "HIGH",      n ? f1(hi) + "c" : "--", (n && hi >= ALERT_C) ? C_RED : C_BLACK);
  statBlock(720, 82, "AVG",       n ? f1(avg) + "c" : "--");
  if (n) txt(470, 156, "low " + hourLab(loH) + "   high " + hourLab(hiH) + "   " + String(n) + " hrs so far", &FreeSans9pt7b);
  display.fillRect(M, 196, SCR_W - 2 * M, 2, C_BLACK);

  // ---- 24-hour bar chart with a cents Y axis ----
  label(M, 218, "TODAY'S HOURLY AVERAGE  (cents per kWh)");
  const int AXW = 42;                                  // room for the Y-axis labels
  const int X0 = M + AXW, X1 = SCR_W - M, Y0 = 230, Y1 = 420;

  float vtop = n ? hi : 0;
  if (!isnan(comedCur) && comedCur > vtop) vtop = comedCur;
  if (vtop < 9) vtop = 9;                              // keep the 8c line on screen on cheap days
  float vmax = vtop * 1.12f;
  float vmin = (n && lo < 0) ? lo * 1.15f : 0;
  float step = (float)(X1 - X0) / 24.0f;
  auto yOf = [&](float v){ return (int)(Y1 - (v - vmin) / (vmax - vmin) * (Y1 - Y0)); };
  int zeroY = yOf(0);

  // Y axis: pick a round tick step giving <= 6 gridlines
  const float CAND[] = {0.5f, 1, 2, 5, 10, 20, 50};
  float tstep = 50;
  for (float c : CAND) if ((vmax - vmin) / c <= 6) { tstep = c; break; }
  display.drawFastVLine(X0 - 6, Y0, Y1 - Y0 + 1, C_BLACK);
  for (float v = ceilf(vmin / tstep) * tstep; v <= vmax + 1e-3f; v += tstep) {
    int gy = yOf(v);
    if (gy < Y0 - 2 || gy > Y1 + 2) continue;
    bool hot = v >= ALERT_C - 1e-3f;                   // 8c and above: red
    uint16_t gc = hot ? C_RED : C_BLACK;
    for (int x = X0; x < X1; x += 8) display.drawPixel(x, gy, gc);
    display.drawFastHLine(X0 - 11, gy, 6, gc);
    txtR(X0 - 14, gy + 5, f0(v), &FreeSans9pt7b, gc);
  }
  display.drawFastHLine(X0 - 6, zeroY, X1 - X0 + 6, C_BLACK);

  for (int h = 0; h < 24; h++) {
    int bx = X0 + (int)(h * step) + 3, bw = (int)step - 6;
    bool inProgress = (h == lt.tm_hour && isnan(comedHour[h]) && !isnan(comedCur));
    float v = inProgress ? comedCur : comedHour[h];
    if (isnan(v)) continue;
    int vy = yOf(v);
    uint16_t c = v >= ALERT_C ? C_RED : C_BLACK;
    int top = v >= 0 ? vy : zeroY, hgt = v >= 0 ? zeroY - vy : vy - zeroY;
    if (hgt < 2) hgt = 2;
    if (inProgress) bar(bx, top, bw, hgt, C_YELLOW);        // yellow = hour still filling
    else            display.fillRect(bx, top, bw, hgt, c);
    if (h % 3 == 0) txtC(bx + bw / 2, 440, hourLab(h), &FreeSans9pt7b);
  }

  // the 8c alert threshold, drawn solid on top of its gridline
  if (ALERT_C >= vmin && ALERT_C <= vmax) {
    int ay = yOf(ALERT_C);
    display.drawFastHLine(X0, ay,     X1 - X0, C_RED);
    display.drawFastHLine(X0, ay + 1, X1 - X0, C_RED);
    txtR(X1 - 4, ay - 7, "8c alert", &FreeSans9pt7b, C_RED);
  }

  footer(String("Updated ") + fmtTime(comedAt) + "   hourlypricing.comed.com   " + WiFi.localIP().toString(),
         "yellow bar = hour in progress");
}

// ---------------- station weather page ----------------
static bool lastRenderOk = true;
void drawPage() {
  time_t now; time(&now);
  header(STATION_NAME, now);
  if (msgText.length() && msgFull) { drawFullMessage(now); return; }

  // ---- left: temperature ----
  uint16_t tcol = (!isnan(cur.tempf) && (cur.tempf <= 32 || cur.tempf >= 90)) ? C_RED : C_BLACK;
  label(M, 90, "TEMPERATURE");
  String ts = f0(cur.tempf);
  uint8_t tsz = ts.length() > 2 ? 2 : 3;        // "-12" or "100" at x3 would run into the hi/lo column
  txt(16, 206, ts, &FreeSansBold24pt7b, tcol, tsz);
  display.setFont(&FreeSansBold24pt7b); display.setTextSize(tsz);
  int tx = 16 + textW(ts) + 14, capH = 34 * tsz;
  display.setTextSize(1);
  degSign(tx + 10, 206 - capH + 16, tsz == 3 ? 9 : 6, tcol);
  txt(tx + 26, 206 - capH / 2 - 3, "F", tsz == 3 ? &FreeSansBold24pt7b : &FreeSansBold18pt7b, tcol);
  hiLoBlock(282, 104, "HIGH TODAY", dayHi, dayHiT);
  hiLoBlock(282, 180, "LOW TODAY",  dayLo, dayLoT);

  // AWN's feelsLike IS wind chill when cold and heat index when hot - name it accordingly.
  const char* flLab = "FEELS LIKE";
  if (!isnan(cur.tempf)) {
    if (cur.tempf <= 50 && !isnan(cur.windMph) && cur.windMph >= 3) flLab = "WIND CHILL";
    else if (cur.tempf >= 80)                                       flLab = "HEAT INDEX";
  }
  statBlock(M,   262, flLab,       f0(cur.feelsLike) + "~");
  statBlock(158, 262, "DEW POINT", f0(cur.dewPoint) + "~");
  statBlock(296, 262, "HUMIDITY",  f0(cur.humidity, "%"));

  // ---- divider ----
  display.fillRect(408, 78, 2, 232, C_BLACK);

  // ---- right: pressure ----
  label(430, 90, "BAROMETRIC PRESSURE  (relative, mb)");
  txt(420, 176, f1(cur.baromRel), &FreeSansBold24pt7b, C_BLACK, 2);   // ~66 px digits
  display.setFont(&FreeSansBold24pt7b); display.setTextSize(2);
  int pw = textW(f1(cur.baromRel)); display.setTextSize(1);
  txt(420 + pw + 8, 176, "mb", &FreeSansBold12pt7b);
  // trend line under the big number: arrow at left, then word + delta
  bool falling = !isnan(trendDelta) && trendDelta <= -TREND_MB;
  uint16_t trc = falling ? C_RED : C_BLACK;
  drawArrow(450, 214, trendDelta, trc);
  if (!isnan(trendDelta)) {
    String d = (trendDelta > 0 ? "+" : "") + f1(trendDelta) + " mb / " + String(trendSpanMin / 60) + "h";
    txt(486, 206, falling ? "FALLING" : (trendDelta >= TREND_MB ? "RISING" : "STEADY"), &FreeSans9pt7b, trc);
    txt(486, 232, d, &FreeSansBold18pt7b, trc);
  }
  // Wind direction lives in the LABEL; units moved into the gust/max labels to fit 800 px.
  String wd = cardinal(isnan(cur.windDir) ? cur.windDirAvg : cur.windDir);
  txt(430, 262, wd.length() ? "WIND " + wd : String("WIND"), &FreeSans9pt7b);
  txt(430, 296, f0(cur.windMph, " mph"), &FreeSansBold18pt7b);
  statBlock(560, 262, "GUST mph",      f0(cur.windGust));
  statBlock(670, 262, "DAY MAX mph",   f0(cur.maxGust));   // "MAX TODAY mph" clipped at 800 px (photo, 6 Oct)
  display.drawFastHLine(M, 308, SCR_W - 2 * M, C_BLACK);

  if (alertLive()) drawAlertBox();
  else if (msgText.length()) drawBannerMessage();
  else {
    // ---- conditions row: UV, solar, sun times, indoor ----
    double sr = NAN, ss = NAN;
    { struct tm lt; localtime_r(&now, &lt);
      sunTimes(lt.tm_year + 1900, lt.tm_mon + 1, lt.tm_mday, SITE_LAT, SITE_LON, tzOffsetSec(now), sr, ss); }
    uint16_t uvc = isnan(cur.uv) ? C_BLACK : cur.uv >= 6 ? C_RED : cur.uv >= 3 ? C_YELLOW : C_BLACK;
    statBlockSm(M,   326, "UV INDEX",   f0(cur.uv), uvc);
    statBlockSm(150, 326, "SOLAR W/m2", f0(cur.solar));
    statBlockSm(280, 326, "SUNRISE",    fmtMin(sr));
    statBlockSm(410, 326, "SUNSET",     fmtMin(ss));
    statBlockSm(540, 326, "DAYLIGHT",   (isnan(sr) || isnan(ss)) ? "--"
                 : String((int)((ss - sr)) / 60) + "h " + String((int)(ss - sr) % 60) + "m");
    statBlockSm(670, 326, "INDOOR",     f0(cur.tempIn) + "F  " + f0(cur.humIn, "%"));

    // ---- rain line ----
    String rain = "RAIN   1h " + f1(cur.rainHour, "\"") + "   today " + f1(cur.dailyRain, "\"") +
                  "   week " + f1(cur.rainWeek, "\"") + "   month " + f1(cur.rainMonth, "\"") +
                  "   year " + f1(cur.rainYear, "\"") + "   last rain " + agoStr(cur.lastRainT, now);
    txt(M, 384, rain, &FreeSans9pt7b);

    // ---- lightning row ----
    // Red when there are strikes in the past hour, yellow when there were strikes earlier today.
    bool ltgRecent = (!isnan(cur.ltgHour) && cur.ltgHour > 0) ||
                     (cur.ltgTime > 0 && (now - cur.ltgTime) < 3600);
    bool ltgToday  = !isnan(cur.ltgDay) && cur.ltgDay > 0;
    uint16_t lcol = ltgRecent ? C_RED : ltgToday ? C_YELLOW : C_BLACK;
    // The bolt itself is always yellow (Bradley, 6 Oct 2026), ringed in black; red only while
    // strikes are landing (past hour). The text keeps the black / yellow / red tiers.
    if (ltgRecent) drawBolt(M, 396, C_RED);
    else { for (int dy = -1; dy <= 1; dy++) for (int dx = -1; dx <= 1; dx++) if (dx || dy) drawBolt(M + dx, 396 + dy, C_BLACK);
           drawBolt(M, 396, C_YELLOW); }
    String ls;
    if (!ltgToday && cur.ltgTime == 0) ls = "No lightning today";
    else {
      ls = f0(cur.ltgDay) + (cur.ltgDay == 1 ? " strike today" : " strikes today");
      if (cur.ltgTime > 0) ls += "   last " + agoStr(cur.ltgTime, now);
      if (!isnan(cur.ltgDist)) ls += "   " + f0(cur.ltgDist) + " mi";
    }
    txt(48, 418, ls, &FreeSans12pt7b, lcol);
  }

  // ---- footer ----
  String foot = "Obs " + fmtTime(cur.t) + "     Updated " + fmtTime(lastGood) +
                "     " + String(fetchOk) + "/" + String(fetchTotal) + " ok     " +
                WiFi.localIP().toString() + "  " + String(WiFi.RSSI()) + " dBm";
  footer(foot, lastRenderOk ? "" : "FETCH ERROR: " + lastErr, C_RED);
}

// Draw the current screen into the frame buffer, push it, and do the ~23 s full refresh.
// The panel is put to deep sleep between refreshes and woken (re-initialised) before the next.
void bbepSendCMDSequence(BBEPDISP *pBBEP, const uint8_t *pSeq);   // bb_epaper internal (bb_ep.inl)

// Draw the screen band by band and stream it to the panel, then do the ~23 s full refresh.
// The panel sleeps between refreshes and is woken (reset + re-init) before the next.
static void pushScreen(void (*draw)()) {
  if (panelAsleep) { bbep.wake(); panelAsleep = false; }
  bbepSendCMDSequence(&bbep._bbep, bbep._bbep.pInitFull);   // BBEP_NEEDS_EXTRA_INIT: resolution before data
  bbep.writeCmd(0x10);
  for (bandX0 = 0; bandX0 < SCR_W; bandX0 += BAND_W) {
    draw();
    for (int i = 0; i < BAND_W; i++) bbep.writeData(band + i * ROW_B, ROW_B);
  }
  bandX0 = 0;
  bbep.refresh(REFRESH_FULL, true);
  bbep.sleep(DEEP_SLEEP); panelAsleep = true;
}
static void drawCurrent() {
  bool msgOwns = msgText.length() && msgFull;
  if      (curScreen == SCR_COMED     && !msgOwns) drawComEd();
  else if (curScreen == SCR_FORECAST  && !msgOwns) drawForecast();
  else if (curScreen == SCR_NEWS      && !msgOwns) drawNews();
  else if (curScreen == SCR_AIR       && !msgOwns) drawAir();
  else if (curScreen == SCR_RIVER     && !msgOwns) drawRiver();
  else if (curScreen == SCR_QUAKE     && !msgOwns) drawQuakes();
  else if (curScreen == SCR_SPACE     && !msgOwns) drawSpace();
  else                                             drawPage();
}
void render(bool ok) {
  lastRenderOk = ok;
  uint32_t t0 = millis();
  pushScreen(drawCurrent);
  Serial.printf("render done in %lu ms (heap %u, largest block %u)\n", (unsigned long)(millis() - t0),
                (unsigned)ESP.getFreeHeap(), (unsigned)ESP.getMaxAllocHeap());
}
static String rmBig, rmSmall; static uint16_t rmCol;
static void drawRenderMessage() {
  time_t now; time(&now);
  header(STATION_NAME, now);
  txtC(SCR_W / 2, SCR_H / 2, rmBig, &FreeSansBold24pt7b, rmCol, 2);
  txtC(SCR_W / 2, SCR_H / 2 + 56, rmSmall, &FreeSans12pt7b);
}
void renderMessage(const String& big, const String& small, uint16_t col = C_BLACK) {
  rmBig = big; rmSmall = small; rmCol = col;
  pushScreen(drawRenderMessage);
}

// Only redraw when what the screen shows has changed (a full refresh is ~23 s of flashing).
static String signature() {
  char b[160];
  snprintf(b, sizeof b, "%ld|%.0f|%.1f|%.0f|%.0f|%.0f|%.0f|%.0f|%.1f|%.1f|%.0f|%ld|%d",
           (long)cur.t, cur.tempf, cur.baromRel, cur.humidity, cur.feelsLike, cur.dewPoint,
           cur.windMph, cur.windGust, cur.dailyRain, trendDelta, cur.ltgDay, (long)cur.ltgTime, histN);
  return String(b);
}
static String lastSig;

// ---------------- web UI / API ----------------
static const char FORM_HTML[] PROGMEM = R"HTML(<!doctype html><html><head><meta charset=utf-8><meta name=viewport content="width=device-width,initial-scale=1">
<title>%NAME% 4-color panel</title><style>body{font-family:sans-serif;max-width:520px;margin:2em auto;padding:0 1em;color:#222}
textarea,input,select,button{width:100%;font-size:1.05em;margin:.35em 0;box-sizing:border-box;padding:.5em}button{background:#b00;color:#fff;border:0;border-radius:6px}
.c button{background:#666}p.s{background:#f3f3f3;padding:.7em;border-radius:6px}</style></head><body>
<h2>%NAME% 4-color panel</h2><p class=s>%STATUS%</p>
<form method=post action=/message><textarea name=text rows=4 maxlength=400 placeholder="Message text (Enter = new line; *red* and ~yellow~ words)"></textarea>
<select name=style><option value=banner>Banner under the weather</option><option value=full>Full screen</option></select>
<small>Tip: wrap words in *asterisks* for red, ~tildes~ for yellow.</small><label>Minutes to show (0 = until cleared)</label><input name=ttl type=number value=60 min=0>
<button>Show on panel (takes ~25 s)</button></form>
<form class=c method=post action=/clear><button>Clear message</button></form>
<h3>Severe weather test</h3>
<form method=post action=/testalert><input type=hidden name=event value="Severe Thunderstorm Warning"><button>Test thunderstorm box</button></form>
<form method=post action=/testalert><input type=hidden name=event value="Tornado Warning"><button>Test tornado box</button></form>
<form class=c method=post action=/alertclear><button>Clear test alert</button></form>
<h3>Screens</h3>
<form method=post action=/screen><input type=hidden name=s value=weather><button>Show weather now</button></form>
<form method=post action=/screen><input type=hidden name=s value=comed><button>Show ComEd prices now</button></form>
<form method=post action=/screen><input type=hidden name=s value=forecast><button>Show forecast now</button></form>
<form method=post action=/screen><input type=hidden name=s value=news><button>Show WSJ headlines now</button></form>
<form method=post action=/screen><input type=hidden name=s value=air><button>Show air &amp; allergy now</button></form>
<form method=post action=/screen><input type=hidden name=s value=river><button>Show river gauge now</button></form>
<form method=post action=/screen><input type=hidden name=s value=space><button>Show space weather now</button></form>
<form method=post action=/screen><input type=hidden name=s value=quake><button>Show earthquakes now</button></form>
<form method=post action=/rotate><label>Rotate every N minutes (0 = off)</label><input name=min type=number value=3 min=0><button>Set rotation</button></form></body></html>)HTML";

static const char* screenName(Screen v) {
  switch (v) {
    case SCR_FORECAST:  return "forecast";
    case SCR_AIR:       return "air";
    case SCR_RIVER:     return "river";
    case SCR_SPACE:     return "space";
    case SCR_QUAKE:     return "quake";
    case SCR_COMED:     return "comed";
    case SCR_NEWS:      return "news";
    default:            return "weather";
  }
}
static String statusLine() {
  String base = String("Screen: ") + (screenName(curScreen)) +
                (rotateMs ? "  (rotating every " + String(rotateMs / 60000) + " min: weather, forecast, comed, air, river)" : "  (rotation off)") +
                "  |  today hi " + (isnan(dayHi) ? String("--") : f1(dayHi) + " at " + fmtTime(dayHiT)) +
                ", lo " + (isnan(dayLo) ? String("--") : f1(dayLo) + " at " + fmtTime(dayLoT)) +
                (alertLive() ? String("  |  *** ") + alertEvent + " (" + alertArea + ") until " + fmtTime(alertEnds)
                               + (alertTest ? " [TEST]" : "") + " ***" : String("  |  no alerts")) + ". ";
  if (!msgText.length()) return base + "No message showing.";
  return base + "Showing (" + (msgFull ? "full screen" : "banner") + ", " + msgExpiryText() + ", rotation paused): " + msgText;
}
static void wantsHtmlRedirect() {          // browser form -> back to the page; curl -> plain text
  if (server.header("Accept").indexOf("text/html") >= 0) { server.sendHeader("Location", "/"); server.send(303); }
  else server.send(200, "text/plain", statusLine() + "\n");
}
static void handleRoot() {
  String h = FPSTR(FORM_HTML); h.replace("%NAME%", STATION_NAME); h.replace("%STATUS%", statusLine());
  server.send(200, "text/html", h);
}
static void handleMessage() {
  String t = server.arg("text"); t.trim();
  { char cb[440]; asciiClean(cb, sizeof cb, t.c_str()); t = cb; t.trim(); }
  if (!t.length()) { server.send(400, "text/plain", "missing text\n"); return; }
  if (t.length() > 400) t = t.substring(0, 400);
  msgText  = t;
  msgFull  = server.arg("style") == "full";
  long ttl = server.hasArg("ttl") ? server.arg("ttl").toInt() : 60;
  msgTtlMs = ttl > 0 ? (uint32_t)ttl * 60000UL : 0;
  msgSetMs = millis();
  if (!msgFull) curScreen = SCR_WEATHER;   // the banner strip is part of the weather layout
  needRender = true;
  Serial.printf("message set (%s, ttl %ld min): %s\n", msgFull ? "full" : "banner", ttl, t.c_str());
  wantsHtmlRedirect();
}
static void handleClear() {
  if (msgText.length()) { msgText = ""; needRender = true; Serial.println("message cleared"); }
  wantsHtmlRedirect();
}
static void startWeb() {
  const char* hdrs[] = {"Accept"}; server.collectHeaders(hdrs, 1);
  server.on("/", HTTP_GET, handleRoot);
  server.on("/message", handleMessage);
  server.on("/clear", handleClear);
  server.on("/alertclear", [](){ alertTest = false; alertActive = false; needRender = true; wantsHtmlRedirect(); });
  server.on("/status", HTTP_GET, [](){ server.send(200, "text/plain", statusLine() + "\n"); });
  server.on("/screen", [](){                       // /screen?s=weather|comed|...  - show one now
    String w = server.arg("s");
    if      (w == "comed")     curScreen = SCR_COMED;
    else if (w == "forecast")  curScreen = SCR_FORECAST;
    else if (w == "news")      curScreen = SCR_NEWS;
    else if (w == "air")       curScreen = SCR_AIR;
    else if (w == "river")     curScreen = SCR_RIVER;
    else if (w == "quake")     curScreen = SCR_QUAKE;
    else if (w == "space")     curScreen = SCR_SPACE;
    else if (w == "weather")   curScreen = SCR_WEATHER;
    else { server.send(400, "text/plain", "s=weather|forecast|air|river|space|quake|comed|news\n"); return; }
    lastRotate = millis(); needRender = true; wantsHtmlRedirect();
  });
  server.on("/testalert", [](){      // verify the red box without waiting for a storm
    String ev = server.hasArg("event") ? server.arg("event") : String("Severe Thunderstorm Warning");
    long m = server.hasArg("min") ? server.arg("min").toInt() : 10;
    strlcpy(alertEvent, ev.c_str(), sizeof alertEvent);
    strlcpy(alertArea, (server.hasArg("area") ? server.arg("area") : String("Lake, IL  (TEST)")).c_str(), sizeof alertArea);
    time_t n; time(&n); alertEnds = n + (m > 0 ? m : 10) * 60;
    alertRank = strstr(alertEvent, "Tornado") ? 2 : 1;
    alertActive = true; alertTest = true; curScreen = SCR_WEATHER; needRender = true;
    Serial.printf("TEST alert: %s for %ld min\n", alertEvent, m);
    wantsHtmlRedirect();
  });
  server.on("/rotate", [](){                       // /rotate?min=N  - 0 turns rotation off
    if (!server.hasArg("min")) { server.send(400, "text/plain", "min=<minutes, 0=off>\n"); return; }
    long m = server.arg("min").toInt();
    rotateMs = m > 0 ? (uint32_t)m * 60000UL : 0;
    lastRotate = millis();
    Serial.printf("rotation set to %ld min\n", m);
    wantsHtmlRedirect();
  });
  server.begin();
  if (MDNS.begin(HOSTNAME)) { MDNS.addService("http", "tcp", 80); Serial.println("mDNS: http://" HOSTNAME ".local"); }
}

// ---------------- WiFi (robust retry for WPA2/WPA3-mixed on WROOM-32) ----------------
bool connectWiFi(uint32_t overall_ms) {
  WiFi.persistent(false);
  WiFi.mode(WIFI_STA);
  WiFi.setSleep(false);
  WiFi.setHostname(HOSTNAME);
  uint32_t start = millis();
  int attempt = 0;
  while (millis() - start < overall_ms) {
    attempt++;
    WiFi.disconnect(true, true);
    delay(250);
    WiFi.begin(WIFI_SSID, WIFI_PASS);
    uint32_t a0 = millis();
    while (WiFi.status() != WL_CONNECTED && millis() - a0 < 8000) delay(150);
    if (WiFi.status() == WL_CONNECTED) {
      Serial.printf("WiFi connected as %s (RSSI %d, try %d)\n",
                    WiFi.localIP().toString().c_str(), WiFi.RSSI(), attempt);
      return true;
    }
    Serial.printf("WiFi try %d failed (status %d)\n", attempt, WiFi.status());
  }
  return false;
}


// ---------------- setup / loop ----------------
uint32_t lastCurrent = 0, lastHistory = 0;
void setup() {
  Serial.begin(115200);
  delay(200);
  Serial.println("\nWeatherPanel4C starting (E2741QS0B3 BWRY, bb_epaper EP74YR_480x800, landscape 800x480) on " BOARD_NAME);

  for (int i = 0; i < 24; i++) comedHour[i] = NAN;   // zero-init would draw 24 bogus 0.0c bars

  band = (uint8_t*)malloc(BAND_W * ROW_B);
  if (!band) { Serial.println("band buffer alloc FAILED"); while (true) delay(1000); }
  bbep.initIO(DC_PIN, RESET_PIN, BUSY_PIN, CS_PIN, MOSI_PIN, SCK_PIN);
  bbep.setRotation(ROTATION);          // only for width()/height(); pixels never touch bb_epaper's buffer
  Serial.printf("panel %d x %d, paged in %d-column bands, heap %u\n", bbep.width(), bbep.height(),
                BAND_W, (unsigned)ESP.getFreeHeap());

  bool wifi = connectWiFi(60000);
  configTzTime("CST6CDT,M3.2.0/2,M11.1.0/2", "pool.ntp.org", "time.nist.gov");
  if (wifi) {
    startWeb();
    uint32_t t0 = millis();                 // give NTP up to 8 s so "Updated" stamps are real
    while (time(nullptr) < 1000000000 && millis() - t0 < 8000) delay(100);
    Serial.printf("NTP %s after %lu ms\n", time(nullptr) < 1000000000 ? "NOT synced" : "synced", (unsigned long)(millis() - t0));
  }

  if (wifi) {
    tryN(fetchHistory, "history"); lastHistory = millis();
    bool ok = tryN(fetchCurrent, "current"); lastCurrent = millis();
    backfillDayHiLo();
    fetchComEd();  lastComed  = millis();
    delay(400); fetchForecast(); lastFc = millis();
    delay(400); fetchAlerts();   lastAlert = millis();
    delay(400); fetchNews();     lastNews  = millis();
    delay(400); fetchAir();      lastAir   = millis();
    delay(400); riverDue = millis() + (tryN(fetchRiver,  "river")  ? RIVER_MS : RETRY_MS);
    delay(400); quakeDue = millis() + (tryN(fetchQuakes, "quakes") ? QUAKE_MS : RETRY_MS);
    delay(400); spaceDue = millis() + (tryN(fetchSpace,  "space")  ? SPACE_MS : RETRY_MS);
    lastSig = signature(); lastRotate = millis();
    render(ok);
  } else {
    renderMessage("No Wi-Fi", String("Could not join ") + WIFI_SSID + " after 60 s - retrying", C_RED);
  }
}
void loop() {
  if (WiFi.status() != WL_CONNECTED) { if (connectWiFi(60000)) { lastCurrent = 0; } return; }
  server.handleClient();
  uint32_t now = millis();
  if (msgText.length() && msgTtlMs && now - msgSetMs >= msgTtlMs) { msgText = ""; needRender = true; Serial.println("message expired"); }
  if (needRender) { needRender = false; lastSig = signature(); render(lastRenderOk); }
  if (now - lastHistory >= HISTORY_MS) { tryN(fetchHistory, "history"); lastHistory = now; }
  if (now - lastComed   >= COMED_MS)   { fetchComEd();                   lastComed   = now; }
  if (now - lastFc      >= FC_MS)      { fetchForecast();                lastFc      = now; }
  if (alertTest && !alertLive()) { alertTest = false; alertActive = false; needRender = true; Serial.println("test alert expired"); }
  if (!alertTest && now - lastAlert >= ALERT_MS) { fetchAlerts(); lastAlert = now; }
  if (now - lastNews >= NEWS_MS) { fetchNews(); lastNews = now; }
  if (now - lastAir   >= AIR_MS)   { fetchAir();    lastAir   = now; }
  if ((int32_t)(now - riverDue) >= 0) riverDue = now + (tryN(fetchRiver,  "river")  ? RIVER_MS : RETRY_MS);
  if ((int32_t)(now - quakeDue) >= 0) quakeDue = now + (tryN(fetchQuakes, "quakes") ? QUAKE_MS : RETRY_MS);
  if ((int32_t)(now - spaceDue) >= 0) spaceDue = now + (tryN(fetchSpace,  "space")  ? SPACE_MS : RETRY_MS);
  if (now - lastCurrent >= CURRENT_MS) {
    bool ok = tryN(fetchCurrent, "current"); lastCurrent = now;
    String sig = signature();
    // Only repaint for new weather data if the weather screen is actually the one showing.
    if (curScreen == SCR_WEATHER && !msgText.length() && (sig != lastSig || ok != lastRenderOk)) {
      lastSig = sig; render(ok);
    } else { lastSig = sig; lastRenderOk = ok; }
  }
  { time_t nw; time(&nw); struct tm lt; localtime_r(&nw, &lt);
    if (dayKey >= 0 && lt.tm_yday != dayKey) { Serial.println("new day - refreshing hi/lo"); backfillDayHiLo(); } }
  // Rotation: paused while a message is up, so the message stays put for its whole TTL.
  if (rotateMs && !msgText.length() && !alertLive() && now - lastRotate >= rotateMs) {
    rotSlot = (rotSlot + 1) % NCYCLE;
    curScreen = CYCLE[rotSlot];
    lastRotate = now;
    Serial.printf("rotate -> %s\n", screenName(curScreen));
    render(lastRenderOk);
  }
  delay(200);
}
