NortonDesignLab/imagotag-e300-dashboard/(commit log)

2026-10-06 Initial commit: nine-screen e-paper dashboard, 4-colour sibling, and printed frame
    WeatherEpaper/ ESP32 + GDEH075Z90 880x528 tri-colour panel. Nine rotating screens
    (weather, NWS forecast, air/allergy, river gauge, space weather,
    US earthquakes, portfolio, ComEd pricing, WSJ headlines) pulled
    straight from ten public endpoints with no intermediary server.
    Severe-weather takeover, HTTP message API with red markup, and a
    time-labelled Kp axis on the space-weather chart.
    WeatherPanel4C/ Same station data on an Imagotag E300 7.4" BWRY (E2741QS0B3),
    gaining yellow as a caution tier between bla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
    [frame_back.stl, frame_both.3mf, frame_both.stl, frame_front.stl, frame_lid.stl]
2026-10-06 Lead with the ESL repurposing story; label the 4-colour Kp axis
    Reframes the project around what is actually novel: a retired SES-imagotag /
    Vusion E300 7.4" shelf label (Pervasive E2741QS0B3, 800x480 BWRY) driven from a
    stock Waveshare ESP32 board with no adapter. WeatherPanel4C is now the headline
    build and the tri-colour GDEH075Z90 version is the sibling.
    Also adds the time-labelled x axis to the 4-colour space-weather chart: the SWPC
    feed already carried time_tag but only the Kp values were kept, so the 3-day
    chart had no time reference. Ticks and "Sat 6p" labels now sit under every 4th
    sample. Verified on hardware (quotes 7/7, indices 5/5, Kp 2.67, 23.6 s refresh).
    Documents a trap fo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
2026-10-06 docs: real E300 identification from the label, plus teardown photos
    Corrects the guide. It previously said BU131 "does not appear in any datasheet
    or in the library" and told people to ignore it - but BU131 is printed on the
    back label and is exactly the string a buyer searches for. The label gives:
    Product E300 7.4 BWRY BU131
    Model EDB2-0740-A
    FCC ID 2ACQM-EDB2-0740-A
    so listings can be matched on the model or FCC ID. The Pervasive E2741QS0B3 is
    the panel inside, which is what bb_epaper cares about, but it is not what the
    seller advertises.
    Also makes the method explicit: the ESL's radio and firmware are never touched.
    The case is snap-fit, the panel's FPC lifts out of a ZIF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
2026-10-06 River screen: match the official NWS hydrograph; add driver-board photo
    The chart auto-scaled to the observed data, so moderate (9 ft) and major (11 ft)
    sat off-chart and a perfectly normal 5.6 ft filled the frame. AHPS instead plots
    a FIXED stage window that always shows every flood category, which is the whole
    point - you want to see how far below flood you are, not a magnified wiggle.
    Now: fixed 4 ft to 12.5 ft window (12.5 clears the 12.1 ft record), hatched
    category bands (yellow action+minor, red moderate+major - hatched because a
    solid red block would dominate a 4-colour panel where AHPS uses a pale wash),
    thresholds drawn and labelled on the chart, stage ticks every 2 ft, and a time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
    [WeatherPanel4C.ino]
2026-10-06 Portfolio screen: drop the table a font step and open up the summary band
    Table goes 12pt -> 9pt with 22px rows (adds FreeSansBold9pt7b). At Bold12
    "TREASURY" was ~136px against a 140px slot, so its note overlapped it; at Bold9
    it clears, and the tighter rows free ~40px at the bottom of the screen.
    That slack pays for the summary band, which was measurably cramped: GFX y is the
    BASELINE, and FreeSans9pt caps rise 13px while FreeSansBold24pt x2 digits are
    70px tall, so baselines 76 and 146 left only 3px between "TOTAL VALUE" and
    "$642,742" - it read as touching. Now 11px there and 9px on both right-hand
    blocks, with the divider and table pushed down 6px to absorb it.
    Gaps computed from the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
    [WeatherPanel4C.ino]
2026-10-07 River: retry a failed fetch in 2 min, and stop the footer overrunning
    USGS waterservices 503s intermittently. A failure during boot left the river
    screen showing "--" and "no history" until the next full interval - 15 minutes -
    which is what the blank screen in testing actually was; the chart code was fine,
    it had nothing to draw. River, quakes and space weather now re-attempt after
    2 min on failure, with due-times compared as signed differences so millis()
    rollover cannot wedge them.
    Footer dropped "Des Plaines River near Lemont", which was running into the
    right-aligned "observed, last 24 h". The title already names the river.
    [WeatherPanel4C.ino]
2026-10-07 frame: bring the standalone open-box generator into the repo
    make_box.py and its two STLs (1 mm and 2 mm wall) sat outside version control
    and had already been swept into the Trash once by a Downloads cleanup. They are
    the parametric open-top box the driver-board enclosure grew out of, and remain
    useful on their own, so they now live under frame/openbox/.
    Verified reproducible after the move: re-running make_box.py regenerates both
    STLs byte-for-byte.
    [open_box_70x100x20_wall1.stl, open_box_70x100x20_wall2.stl]
2026-10-07 Add requirements.txt for the host-side tooling
    Moving the project out of ~/Downloads meant the venv had to be recreated, and
    only esptool/pyserial came back - numpy, manifold3d and matplotlib did not. The
    committed STLs still looked fine, so nothing appeared wrong until make_box.py
    was run and failed on "No module named numpy". Pin the full host dependency set
    so a rebuilt venv restores both halves, CAD and flashing.
    Verified afterwards: both generators reproduce every STL byte-for-byte.
2026-10-08 WeatherEpaper: rotate only weather/forecast/pollen; fetch retired screens on demand
    frame: 3mf re-saved from the slicer with plate and slice settings (7 Oct 2026)
    [frame_both.3mf]
2026-10-08 Move the site location into secrets.h
    Coordinates, NWS grid, pollen ZIP, river name/gauge/NWSLI and flood stages
    were hardcoded in both dashboard sketches. They now come from secrets.h, and
    secrets.h.example ships a working downtown-Chicago demo (LOT/76,73, 60606,
    Des Plaines River near Lemont / LEMI2).
2026-10-13 Add Seeed XIAO ePaper Display Board EE04 (ESP32-S3 Plus) as a second driver board
    WeatherPanel4C now selects its pins and mDNS hostname from the board macro:
    the Waveshare Rev3 (WROOM-32) build is unchanged as ndl-panel, and a build
    for the XIAO ESP32-S3 Plus uses the EE04 pins (DC 10, RST 38, BUSY 4, CS 44,
    SCK 7, MOSI 9) as ndl-panel-s3 so both boards can share a LAN. The band-paged
    renderer is kept on the S3 for a single code path, although it has the RAM for
    a full frame. Verified on hardware: all feeds fetched, 23.6 s render.
    Also adds Imagotag74Test_EE04, the four-colour bring-up test for that board,
    and documents both boards and their build commands in the README.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
2026-10-27 Drop the portfolio screen, rotate five screens, fix ComEd hours
    - Remove the portfolio: holdings, Yahoo quotes and index strip,
    the screen, its web button and its secrets.h.example block.
    - Rotation is now a plain CYCLE[]: weather, forecast, electricity,
    air & allergy, river. Space, quakes and news stay reachable
    via /screen.
    - ComEd's day feed is hour-ending (entry 18 = the 5-6 pm average),
    so each entry now goes into slot H-1. Bars were one hour late and
    the in-progress hour never showed.
    - README updated to match.
    [WeatherPanel4C.ino]
